adampaigge/openplane/files/dxf/parts/F-TT1.dxf

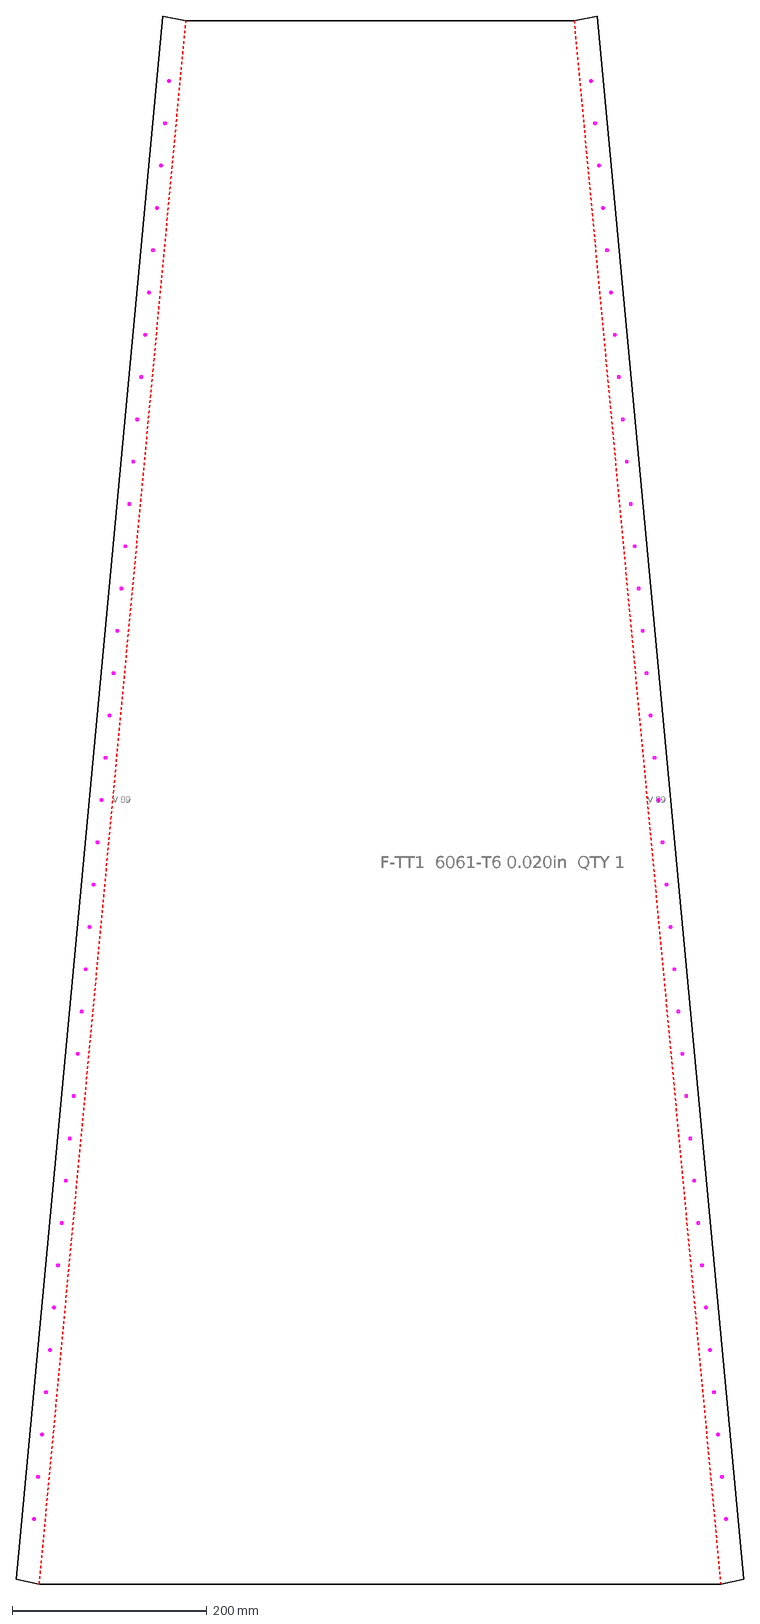
[picture p1: CAD file, 2026-10-21]
files/dxf/parts/F-TT1.dxf
V 89
F-TT1 6061-T6 0.020in QTY 1
