adampaigge/openplane/files/prop/OpenPlane_prop_54x24.stl

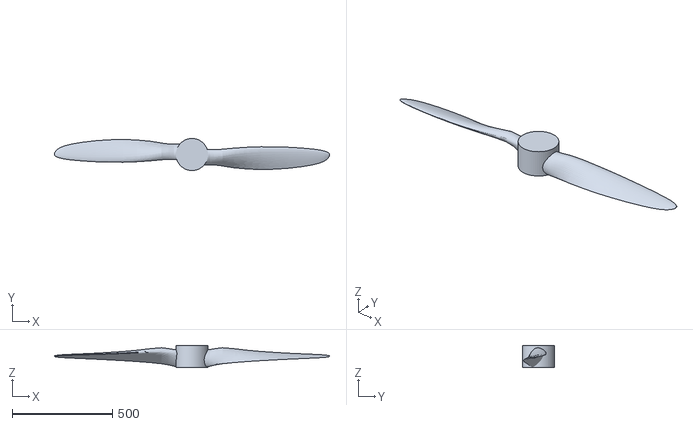
[picture p2: CAD file, 2026-10-21]
files/prop/OpenPlane_prop_54x24.stl
1371.6 x 160.0 x 110.6
