adampaigge/openplane/files/dxf/nests/4130_steel_0063in_01.dxf

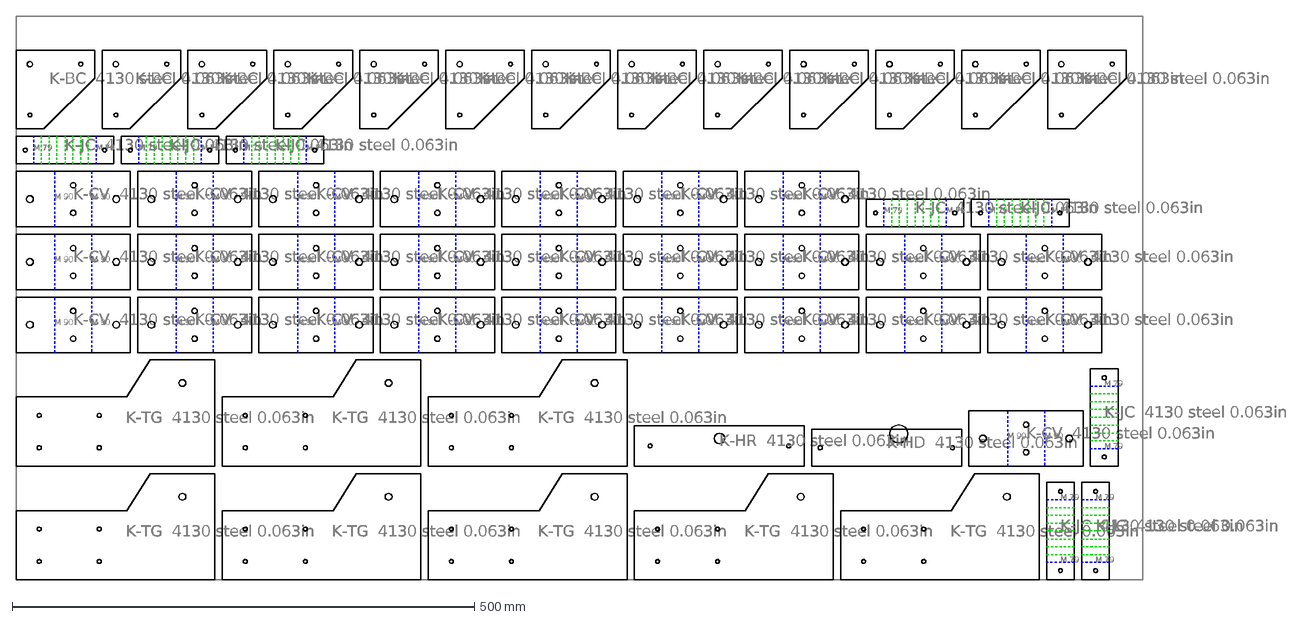
[picture p3: CAD file, 2026-10-21]
files/dxf/nests/4130_steel_0063in_01.dxf
K-TG 4130 steel 0.063in
K-HR 4130 steel 0.063in
K-HD 4130 steel 0.063in
M 90
K-CV 4130 steel 0.063in
M 79
K-JC 4130 steel 0.063in
K-BC 4130 steel 0.063in
