adampaigge/openplane/files/dxf/parts/K-HN.dxf

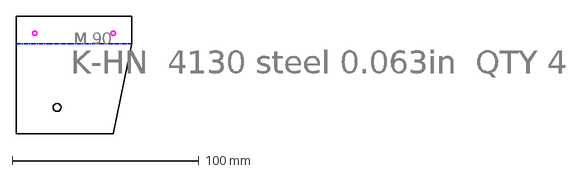
[picture p4: CAD file, 2026-10-21]
files/dxf/parts/K-HN.dxf
M 90
K-HN 4130 steel 0.063in QTY 4
