adampaigge/openplane/files/dxf/parts/T-FR.dxf

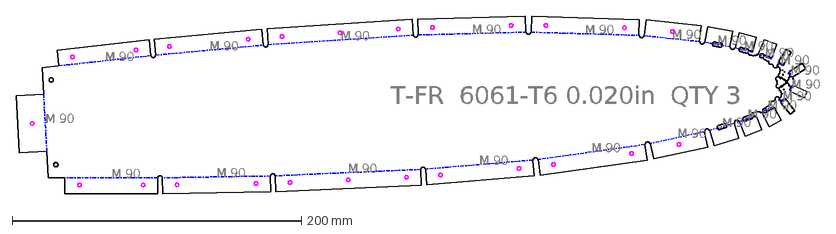
[picture p5: CAD file, 2026-10-21]
files/dxf/parts/T-FR.dxf
M 90
T-FR 6061-T6 0.020in QTY 3
