adampaigge/openplane/files/dxf/parts/T-HR.dxf

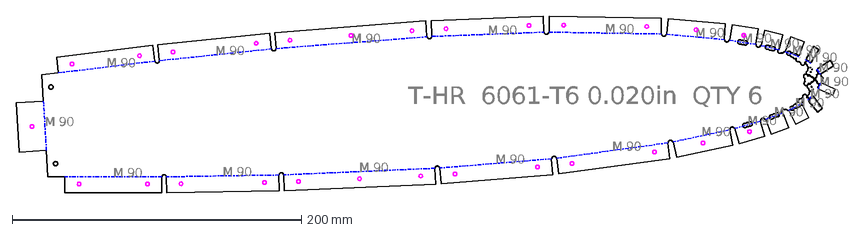
[picture p6: CAD file, 2026-10-21]
files/dxf/parts/T-HR.dxf
M 90
T-HR 6061-T6 0.020in QTY 6
