adampaigge/openplane/files/dxf/nests/6061-T6_0020in_19.dxf

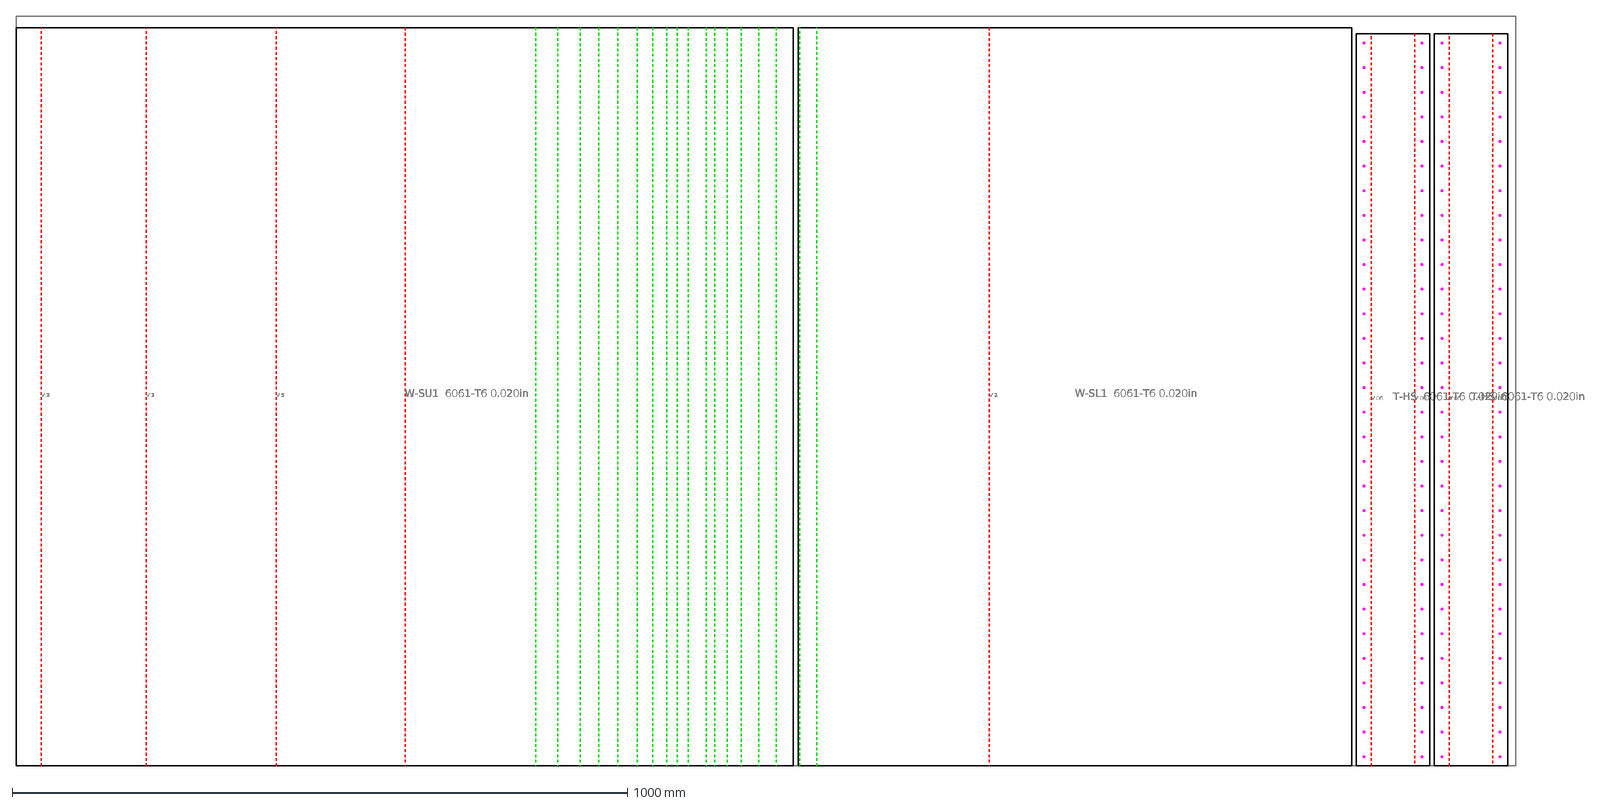
[picture p7: CAD file, 2026-10-21]
files/dxf/nests/6061-T6_0020in_19.dxf
V 9
V 5
V 3
W-SU1 6061-T6 0.020in
V 2
W-SL1 6061-T6 0.020in
V 86
T-HS 6061-T6 0.020in
