adampaigge/openplane/files/dxf/parts/T-FS.dxf

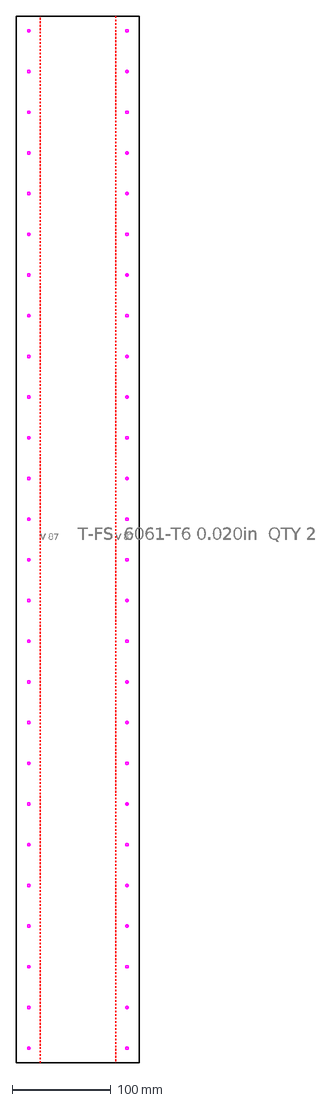
[picture p8: CAD file, 2026-10-21]
files/dxf/parts/T-FS.dxf
V 87
T-FS 6061-T6 0.020in QTY 2
