adampaigge/openplane/files/dxf/parts/K-HR.dxf

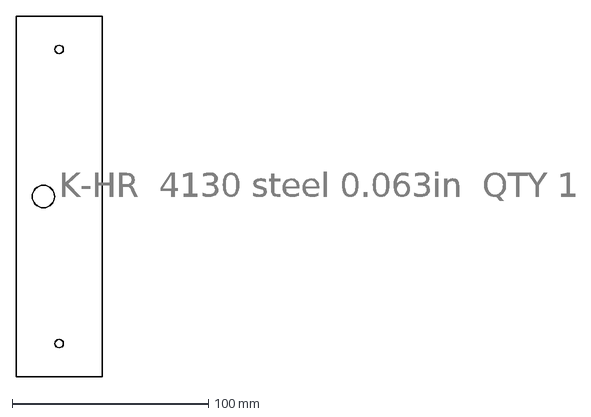
[picture p9: CAD file, 2026-10-21]
files/dxf/parts/K-HR.dxf
K-HR 4130 steel 0.063in QTY 1
