adampaigge/openplane/files/dxf/parts/W-MRe.dxf

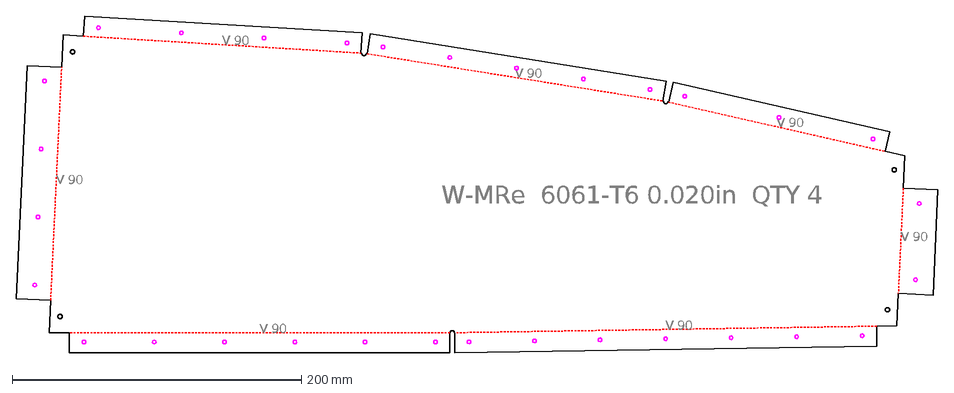
[picture p10: CAD file, 2026-10-21]
files/dxf/parts/W-MRe.dxf
V 90
W-MRe 6061-T6 0.020in QTY 4
