adampaigge/openplane/files/dxf/parts/F-NU.dxf

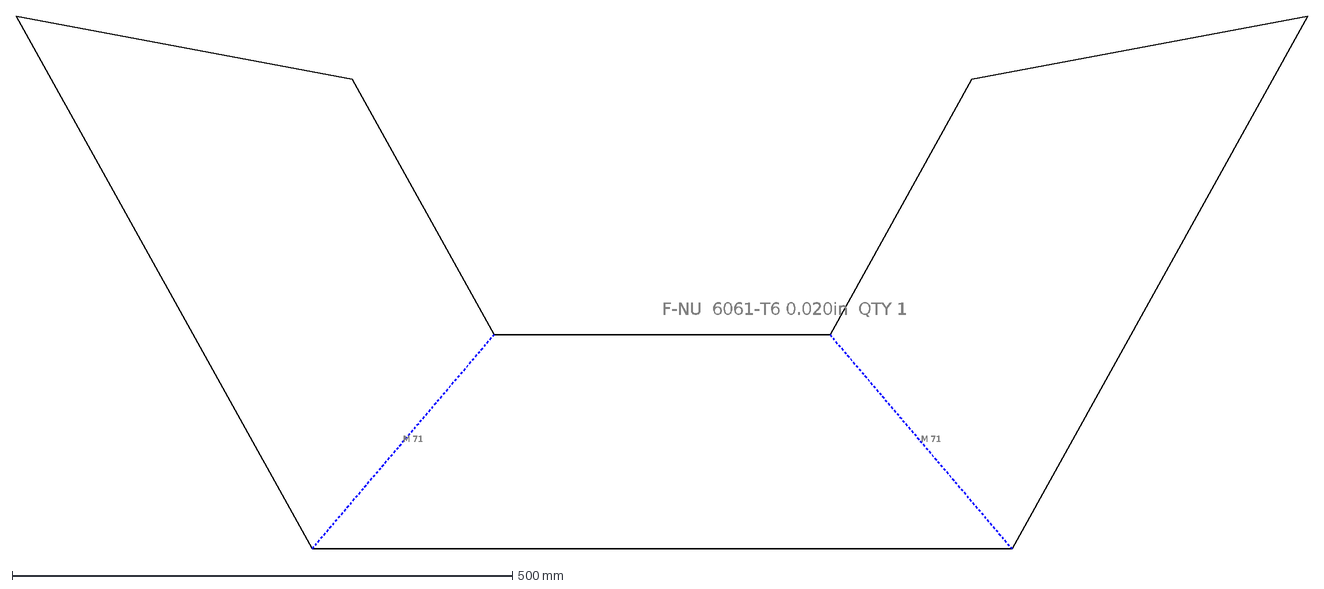
[picture p11: CAD file, 2026-10-21]
files/dxf/parts/F-NU.dxf
M 71
F-NU 6061-T6 0.020in QTY 1
