adampaigge/openplane/files/dxf/parts/W-SU1.dxf

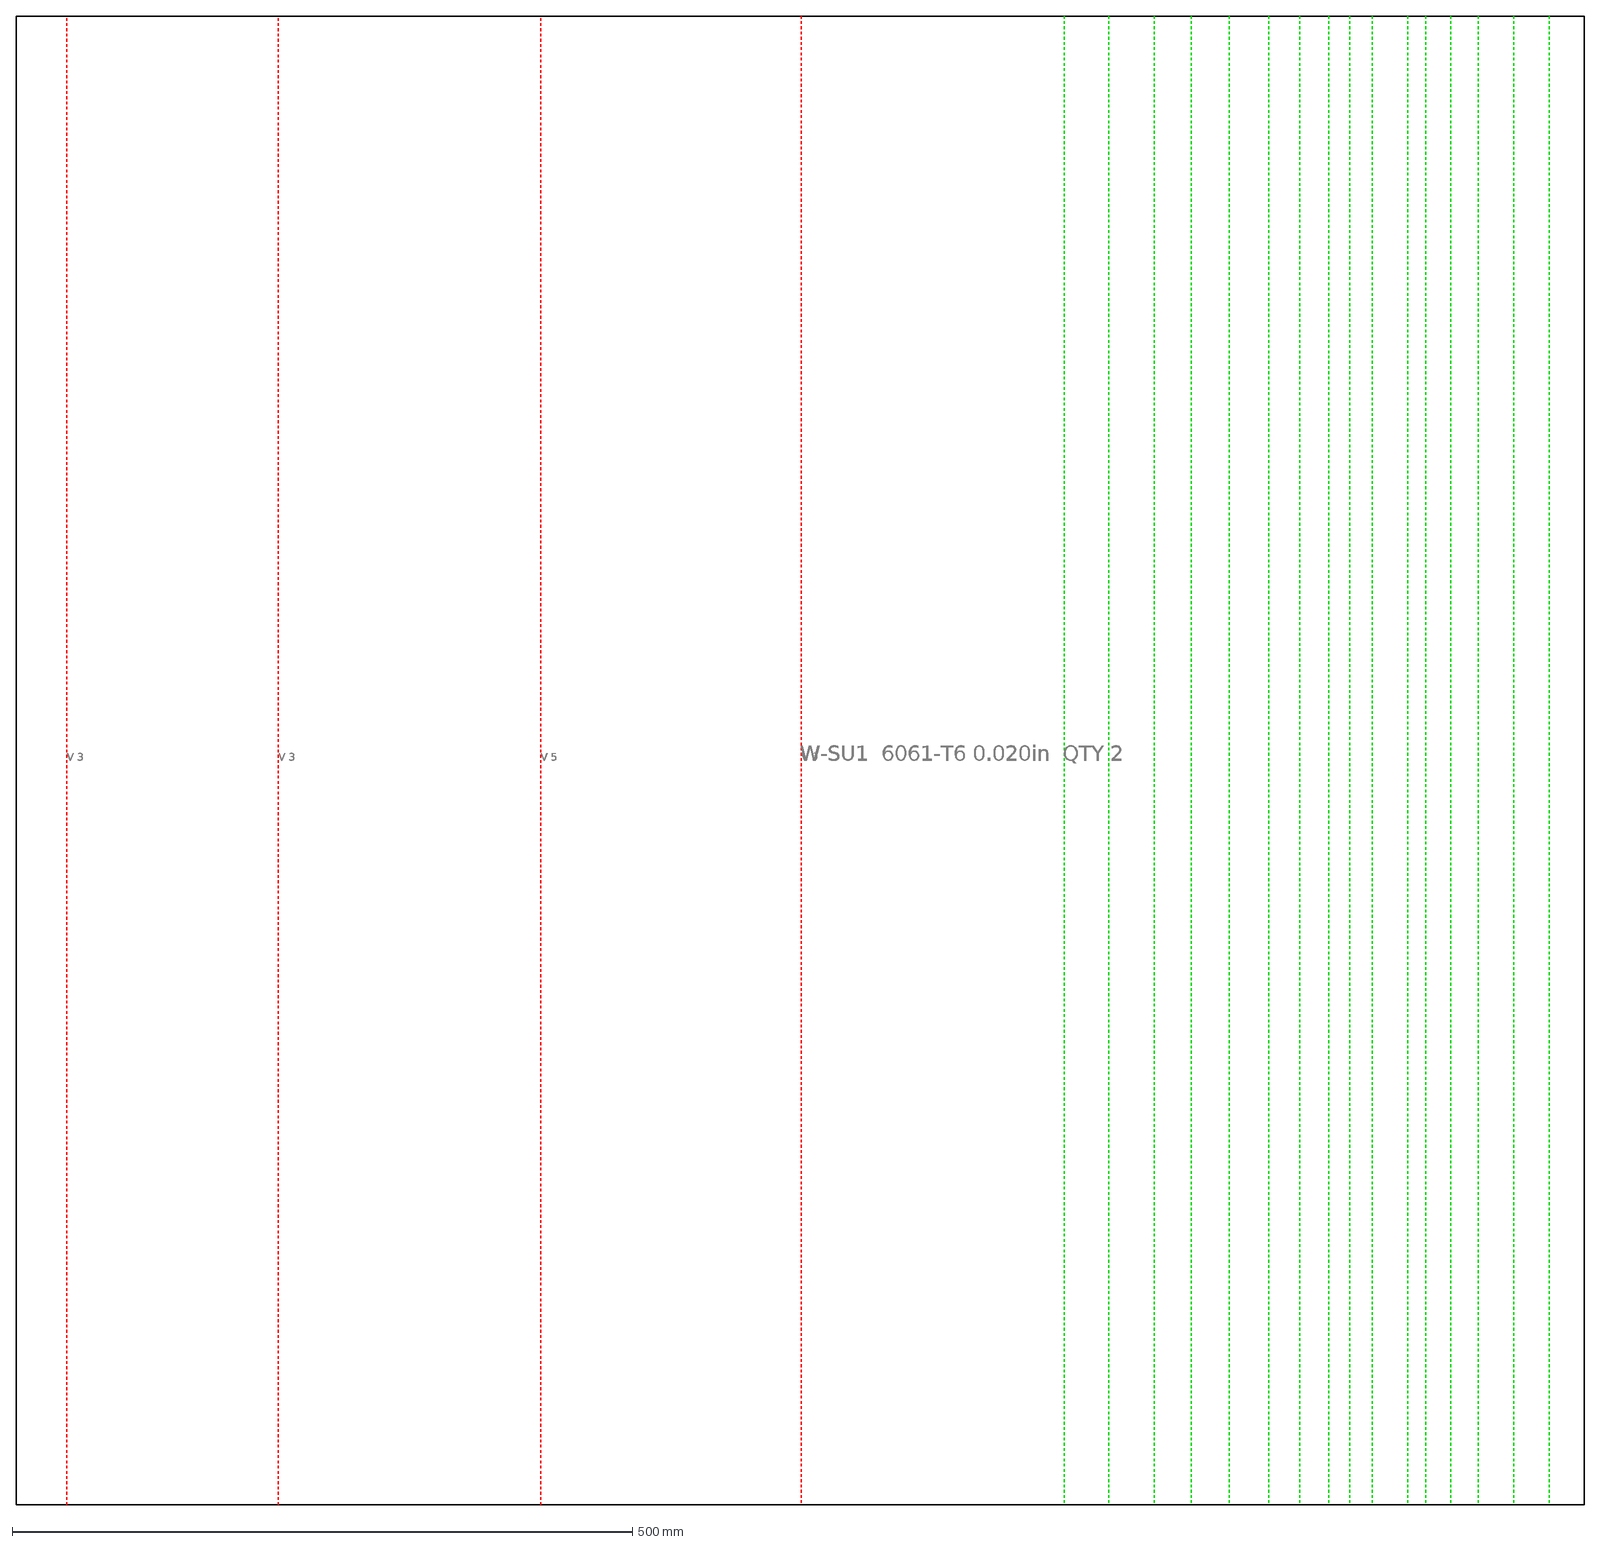
[picture p12: CAD file, 2026-10-21]
files/dxf/parts/W-SU1.dxf
V 9
V 5
V 3
W-SU1 6061-T6 0.020in QTY 2
