adampaigge/openplane/files/dxf/parts/F-B1.dxf

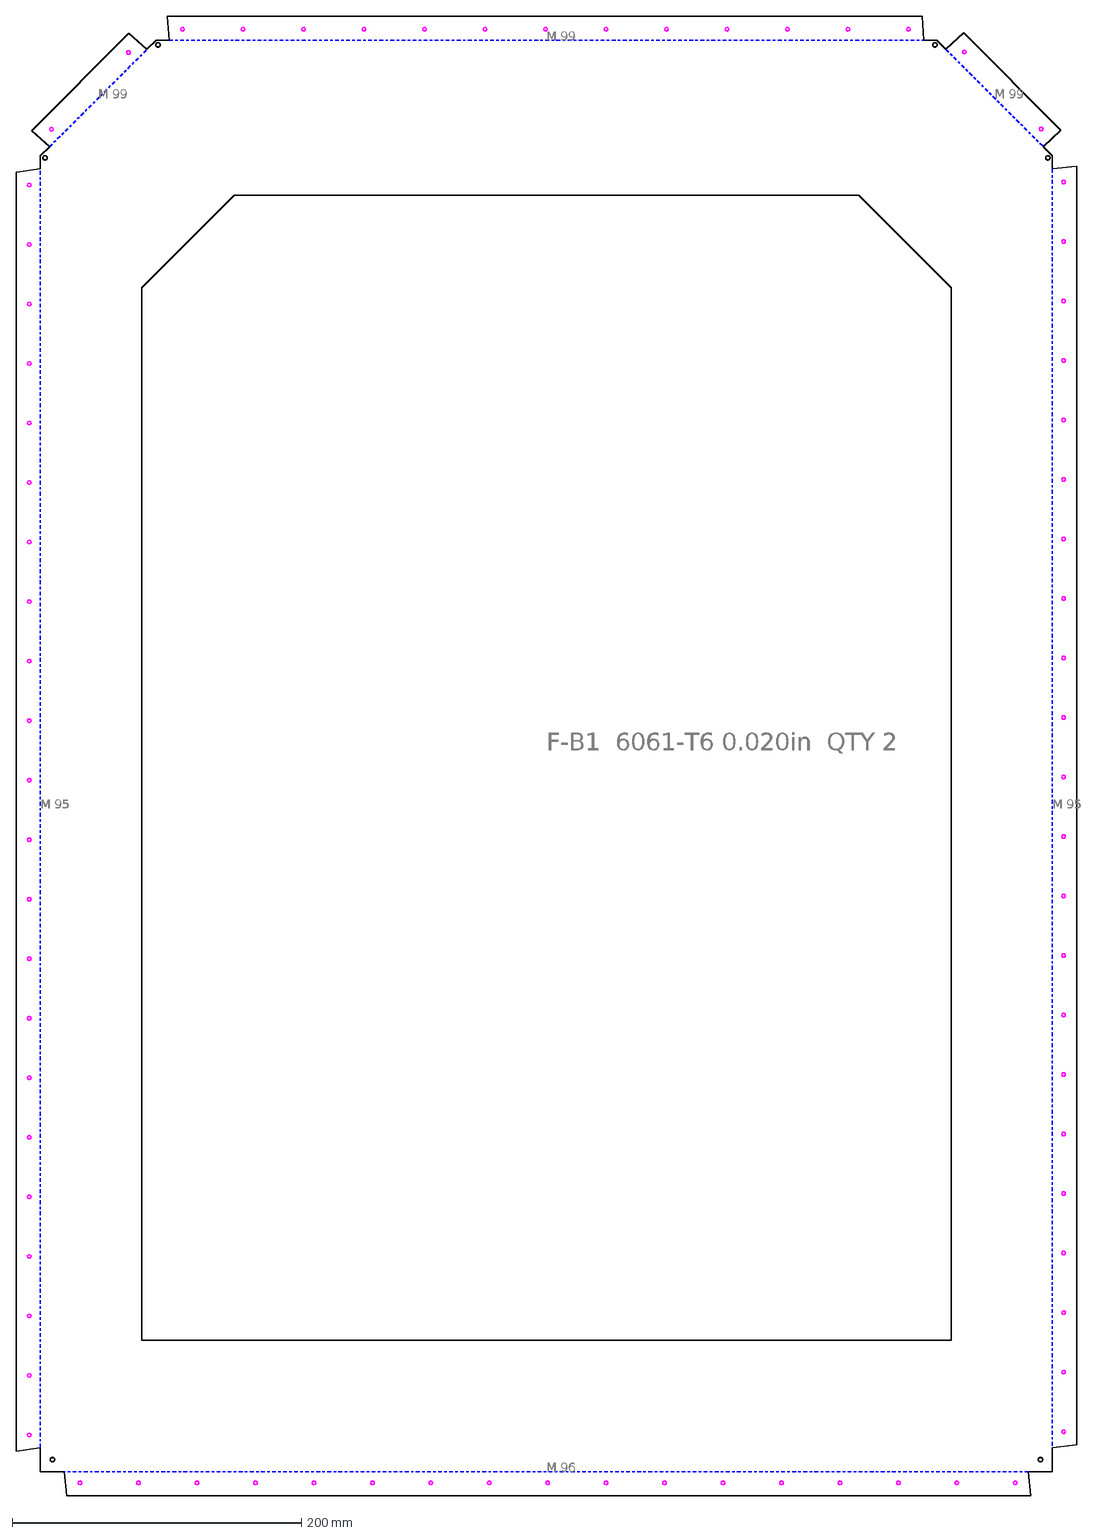
[picture p13: CAD file, 2026-10-21]
files/dxf/parts/F-B1.dxf
M 96
M 95
M 99
F-B1 6061-T6 0.020in QTY 2
