adampaigge/openplane/files/dxf/parts/F-CL.dxf

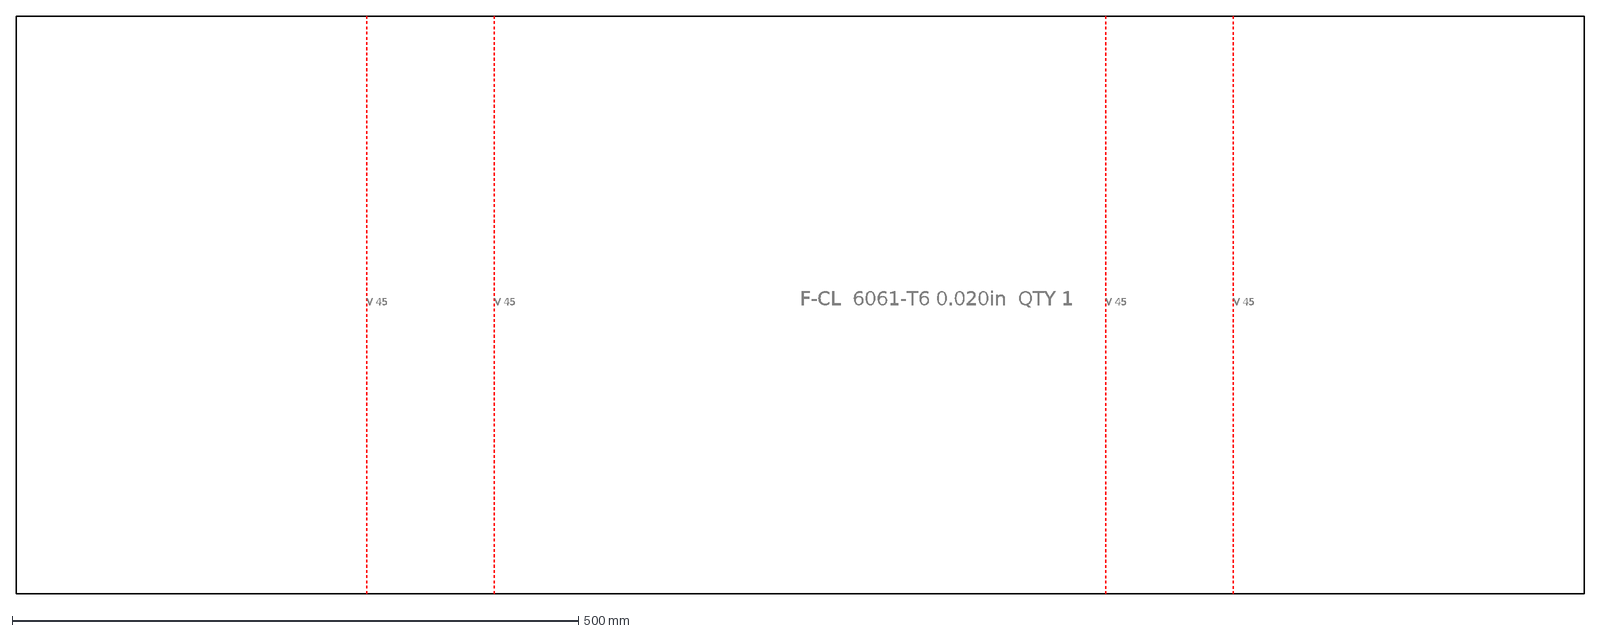
[picture p14: CAD file, 2026-10-21]
files/dxf/parts/F-CL.dxf
V 45
F-CL 6061-T6 0.020in QTY 1
