adampaigge/openplane/files/dxf/parts/F-CU.dxf

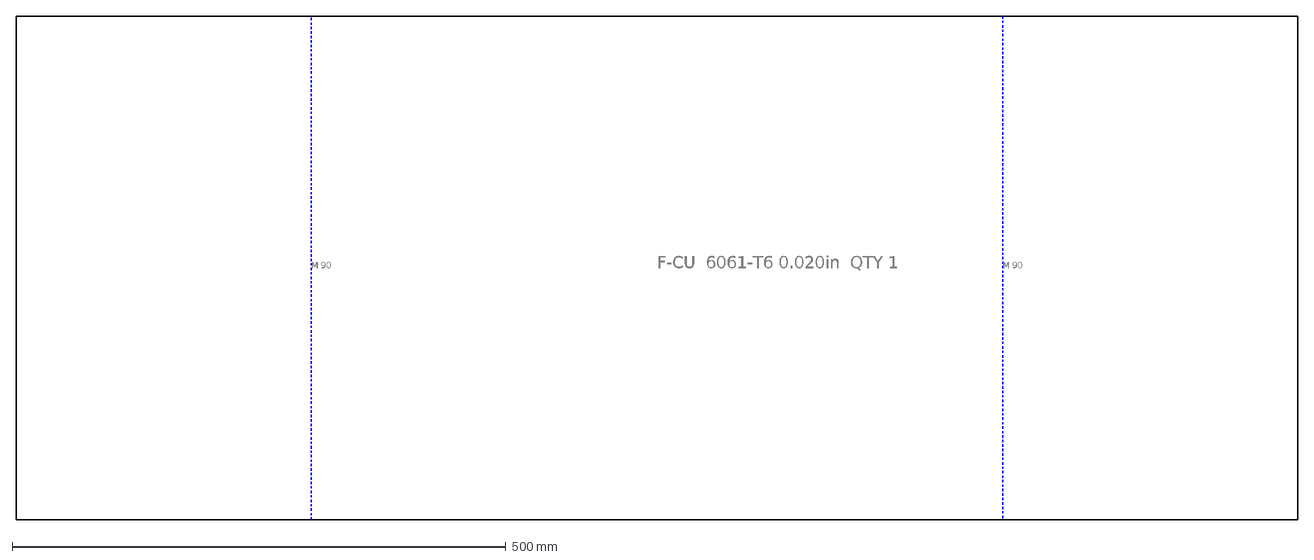
[picture p15: CAD file, 2026-10-21]
files/dxf/parts/F-CU.dxf
M 90
F-CU 6061-T6 0.020in QTY 1
