adampaigge/openplane/files/dxf/parts/F-SD.dxf

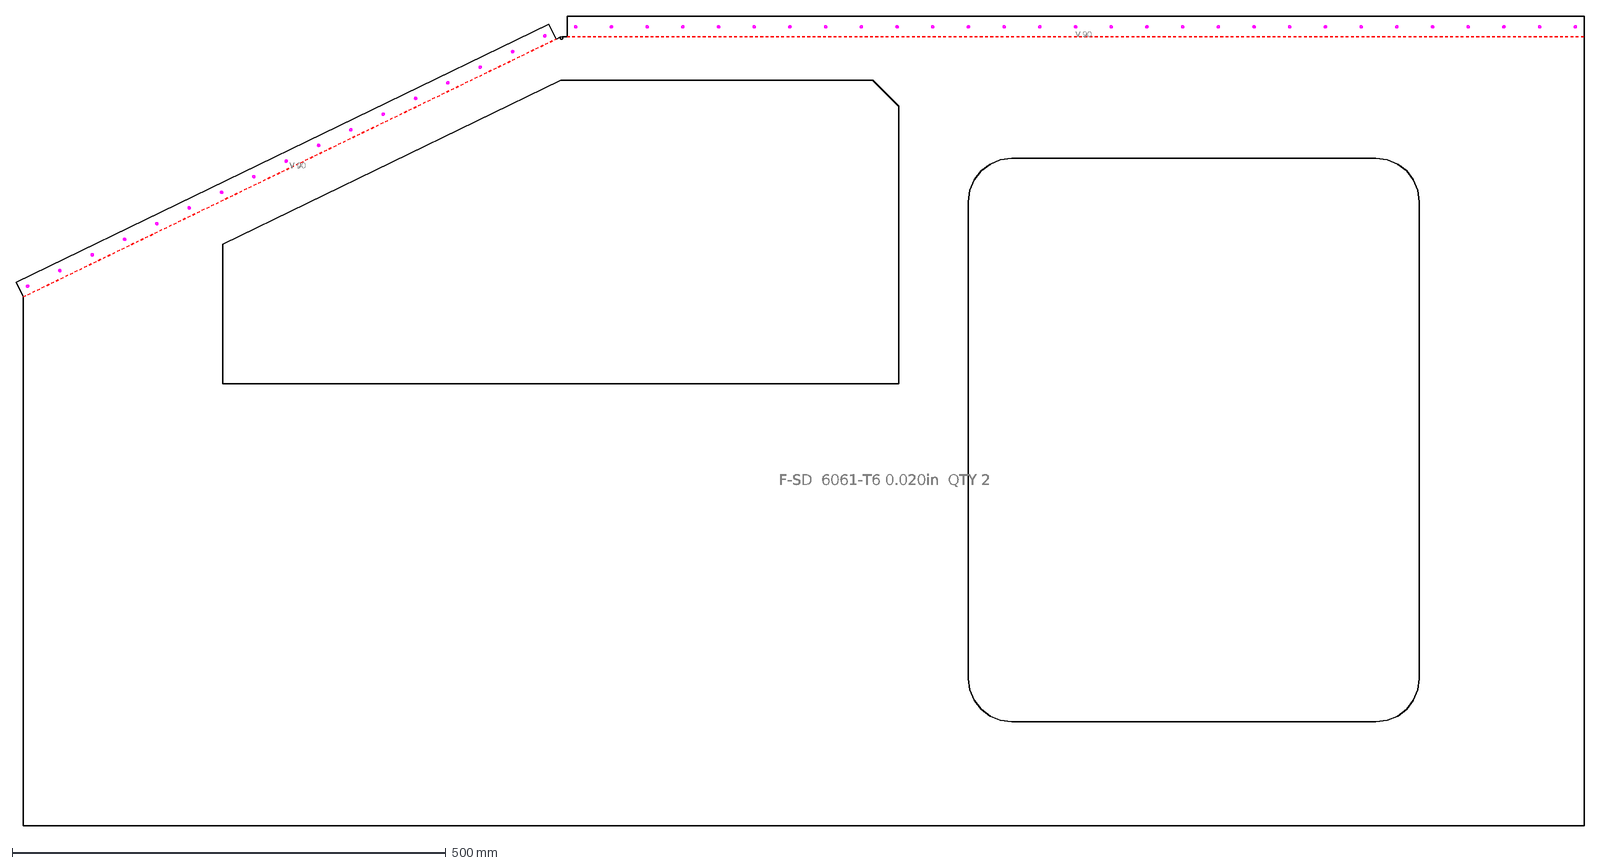
[picture p16: CAD file, 2026-10-21]
files/dxf/parts/F-SD.dxf
V 90
F-SD 6061-T6 0.020in QTY 2
