adampaigge/openplane/files/dxf/parts/F-NF.dxf

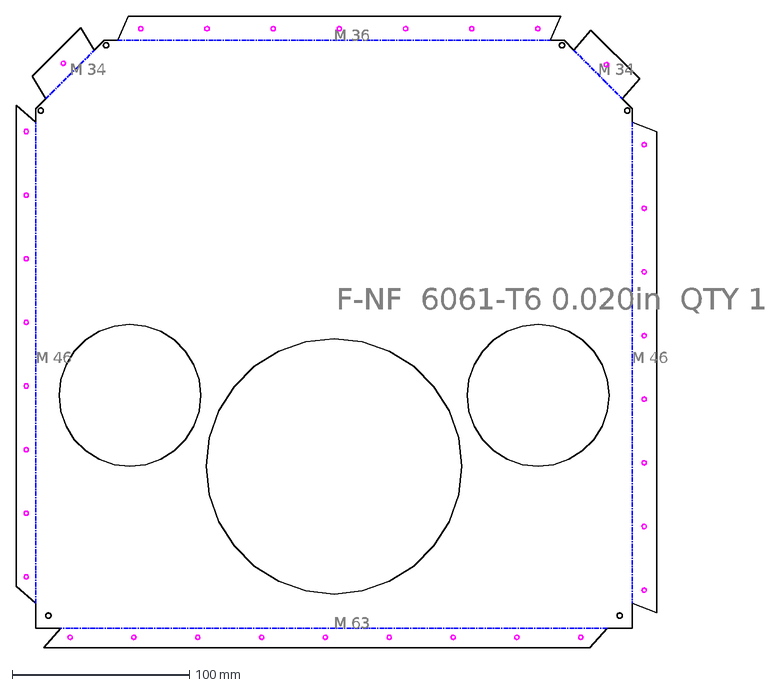
[picture p17: CAD file, 2026-10-21]
files/dxf/parts/F-NF.dxf
M 63
M 46
M 34
M 36
F-NF 6061-T6 0.020in QTY 1
