adampaigge/openplane/files/dxf/parts/T-RS.dxf

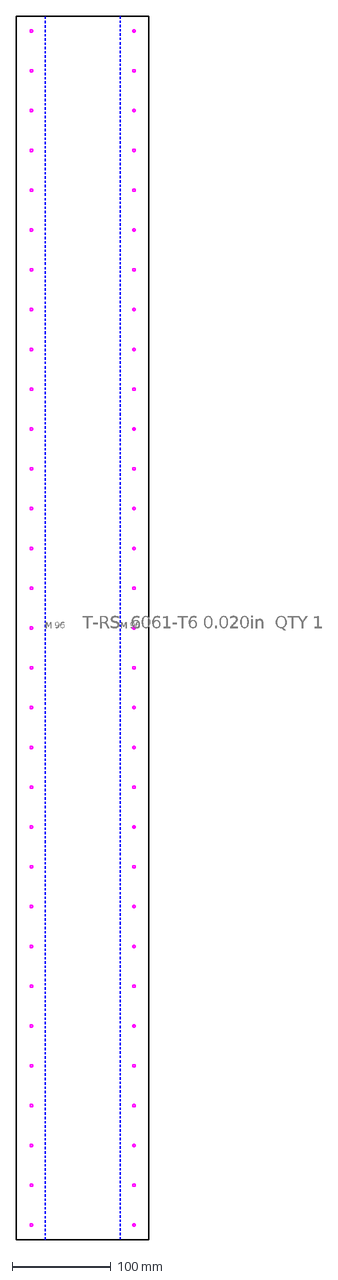
[picture p18: CAD file, 2026-10-21]
files/dxf/parts/T-RS.dxf
M 96
T-RS 6061-T6 0.020in QTY 1
