adampaigge/openplane/files/dxf/parts/T-FK.dxf

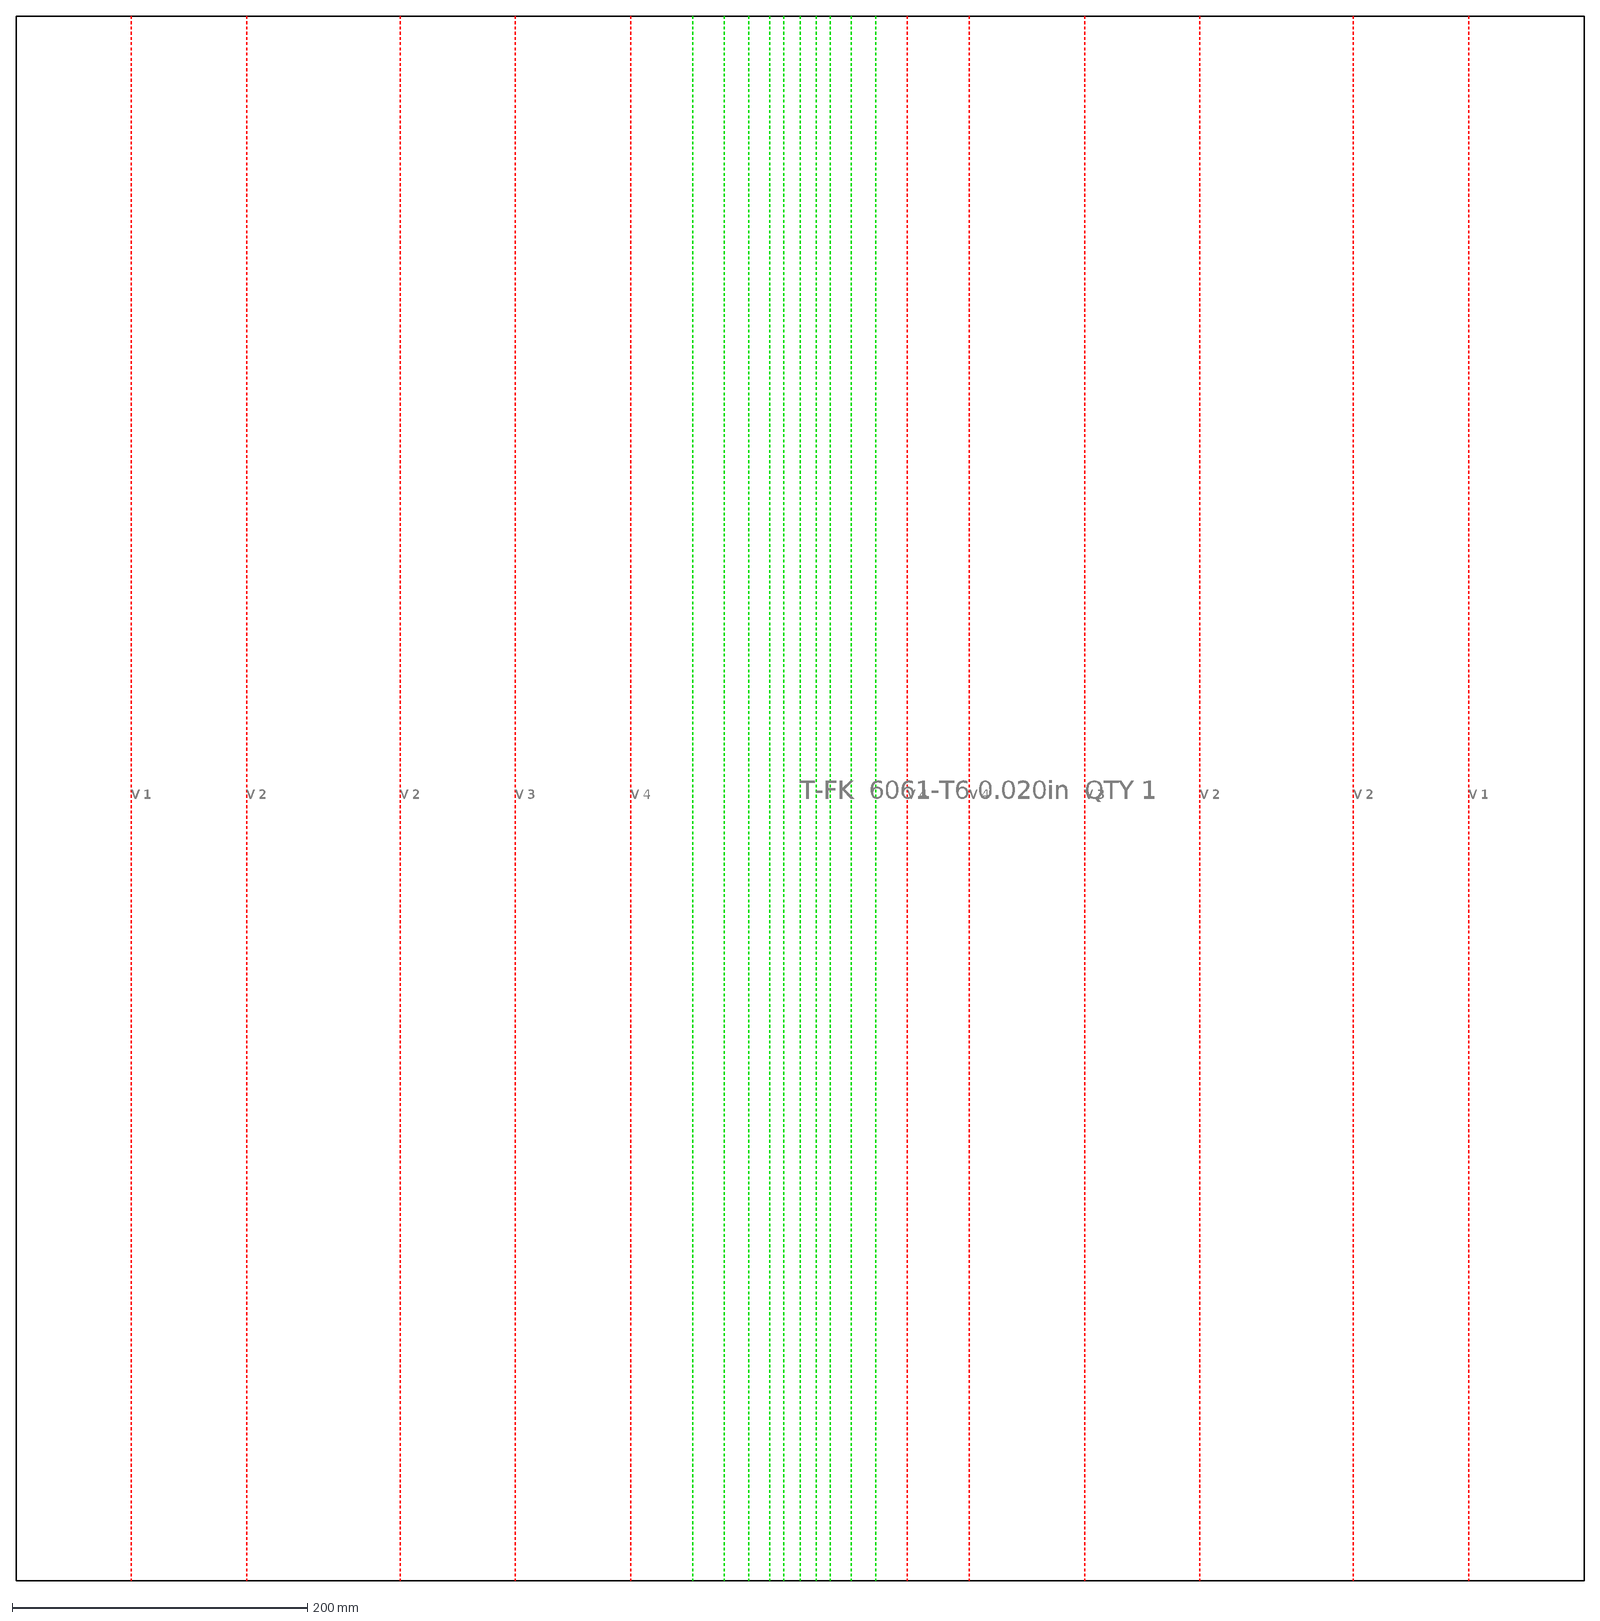
[picture p19: CAD file, 2026-10-21]
files/dxf/parts/T-FK.dxf
V 1
V 2
V 3
V 4
T-FK 6061-T6 0.020in QTY 1
