adampaigge/openplane/files/dxf/nests/6061-T6_0020in_15.dxf

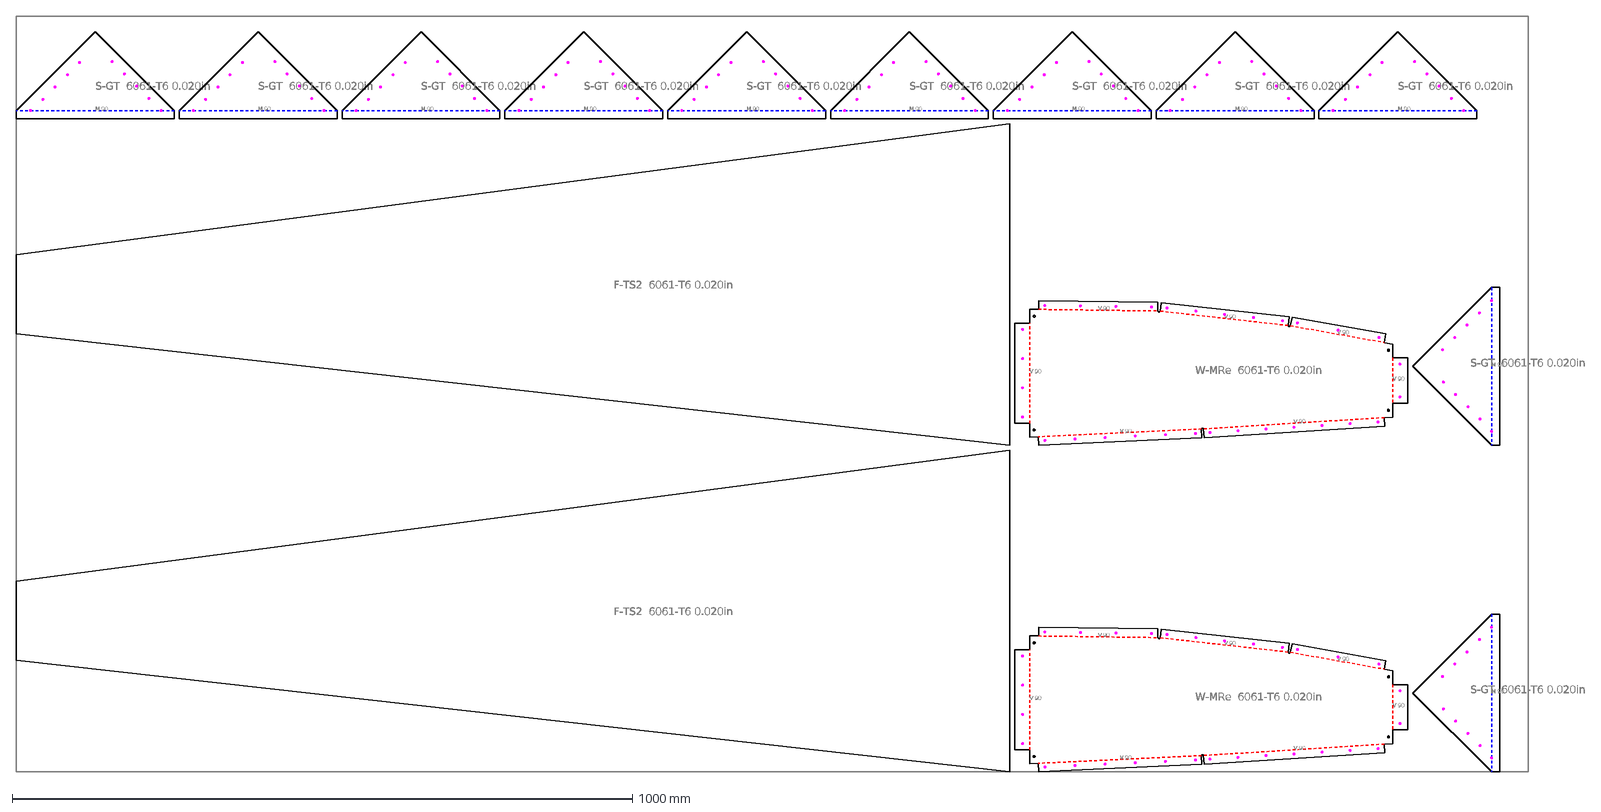
[picture p20: CAD file, 2026-10-21]
files/dxf/nests/6061-T6_0020in_15.dxf
F-TS2 6061-T6 0.020in
V 90
W-MRe 6061-T6 0.020in
M 90
S-GT 6061-T6 0.020in
