adampaigge/openplane/files/dxf/parts/W-SL1.dxf

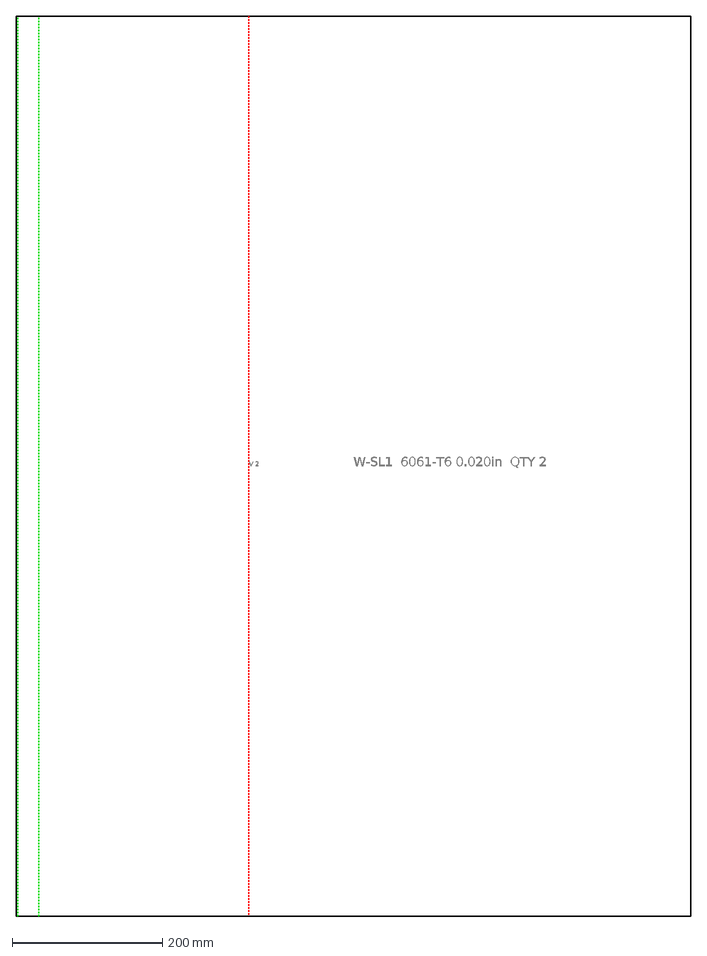
[picture p21: CAD file, 2026-10-21]
files/dxf/parts/W-SL1.dxf
V 2
W-SL1 6061-T6 0.020in QTY 2
