adampaigge/openplane/files/dxf/parts/F-B4.dxf

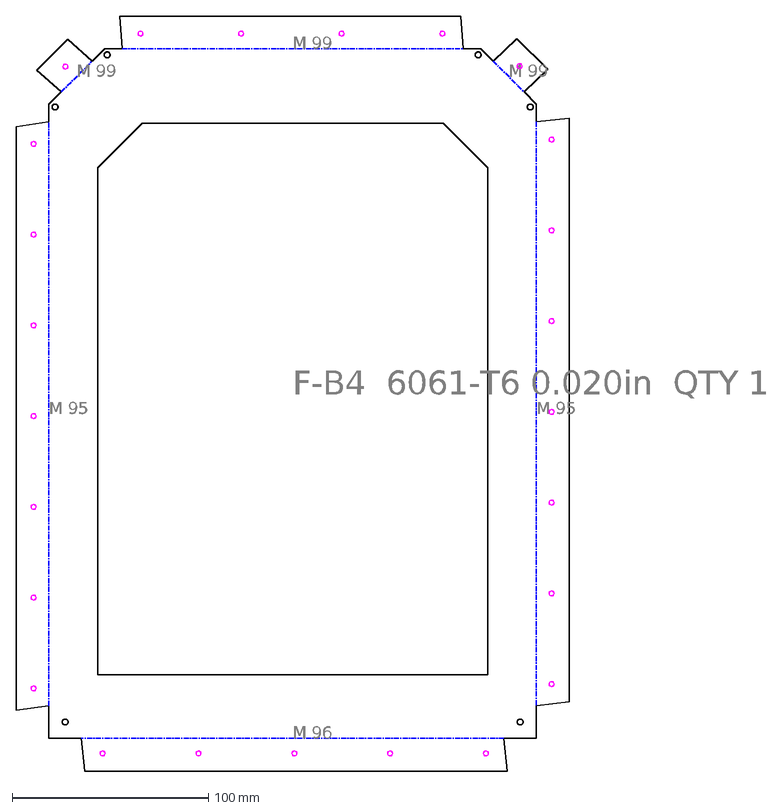
[picture p22: CAD file, 2026-10-21]
files/dxf/parts/F-B4.dxf
M 96
M 95
M 99
F-B4 6061-T6 0.020in QTY 1
