adampaigge/openplane/files/dxf/parts/T-HK.dxf

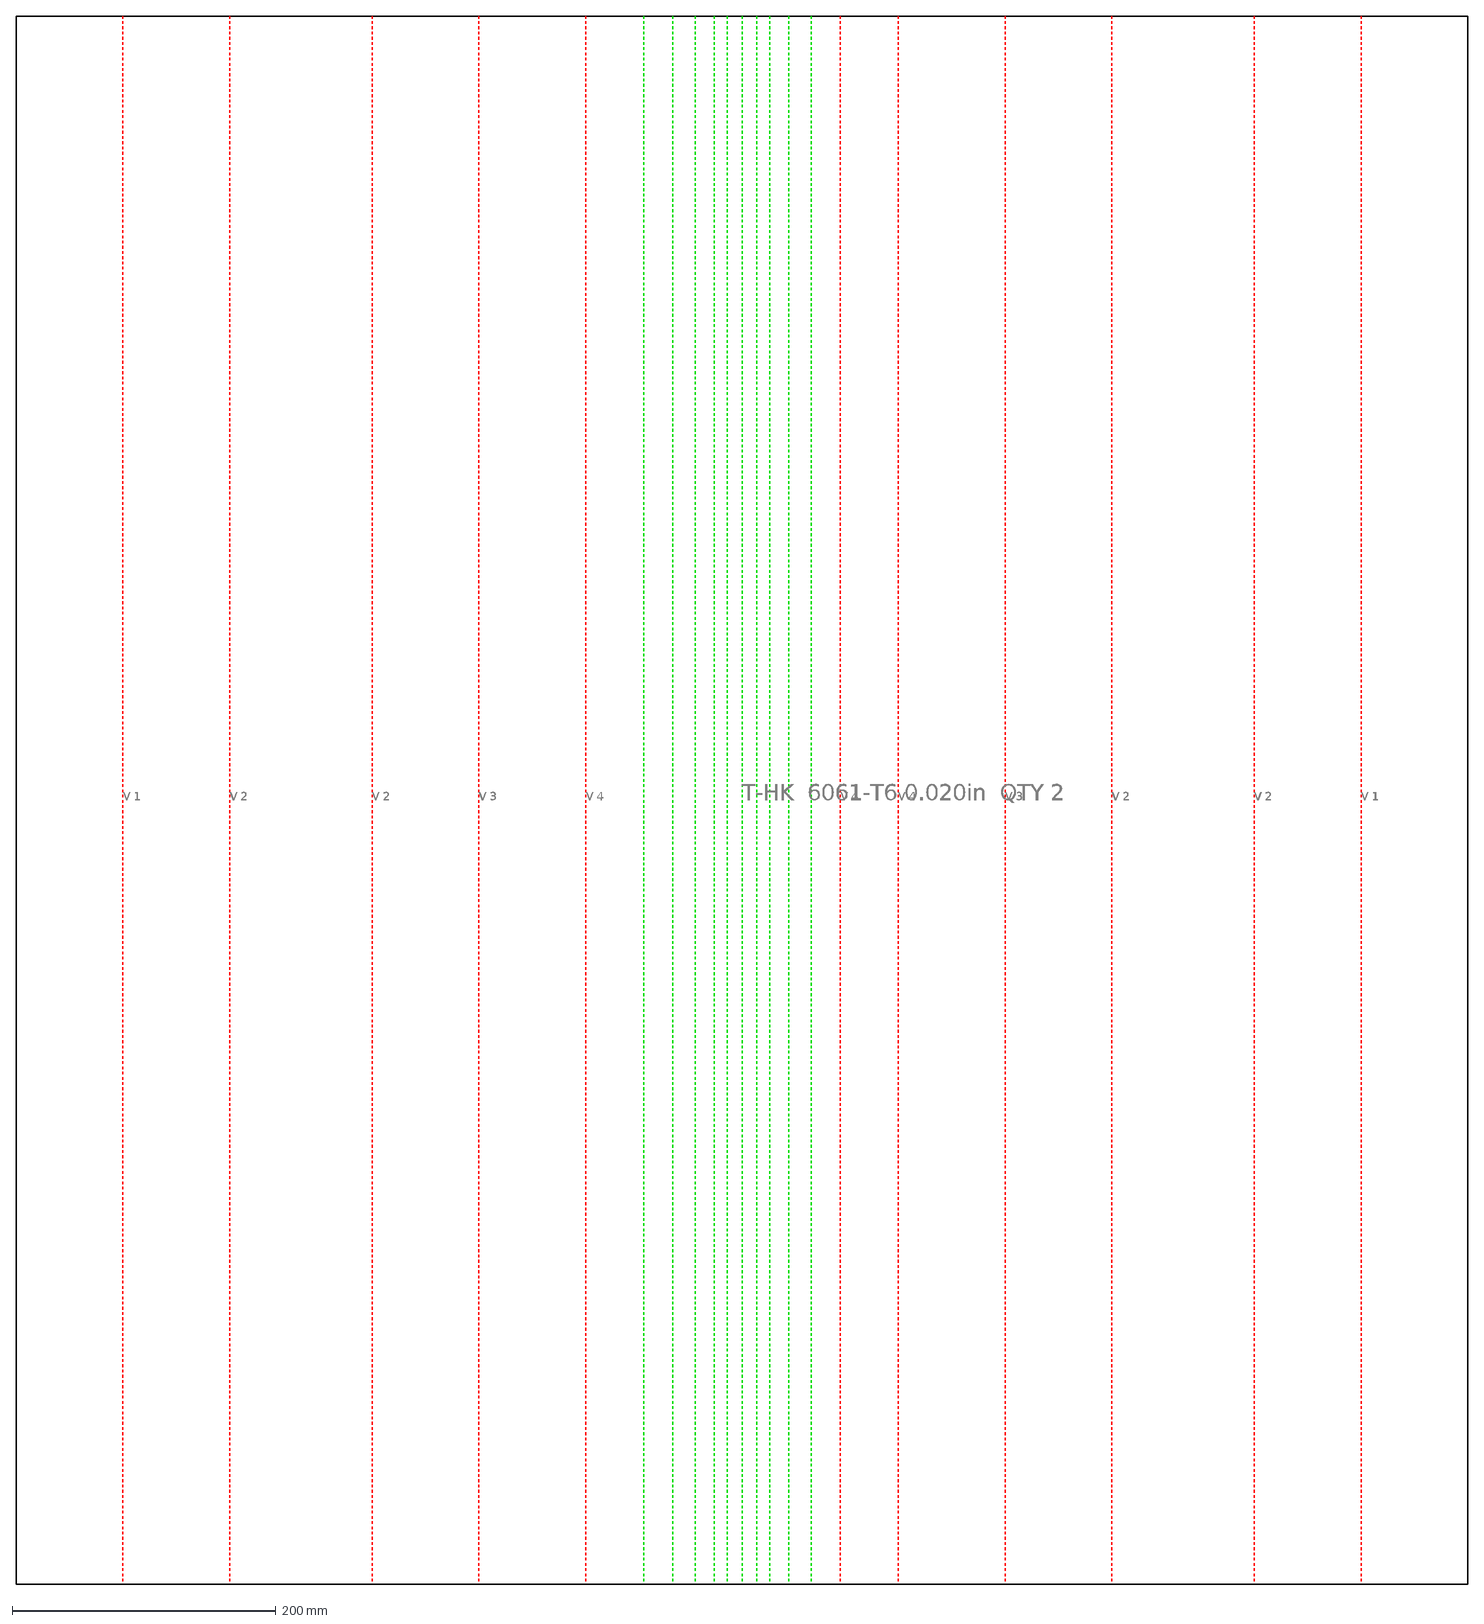
[picture p23: CAD file, 2026-10-21]
files/dxf/parts/T-HK.dxf
V 1
V 2
V 3
V 4
T-HK 6061-T6 0.020in QTY 2
