adampaigge/openplane/files/dxf/parts/S-LG.dxf

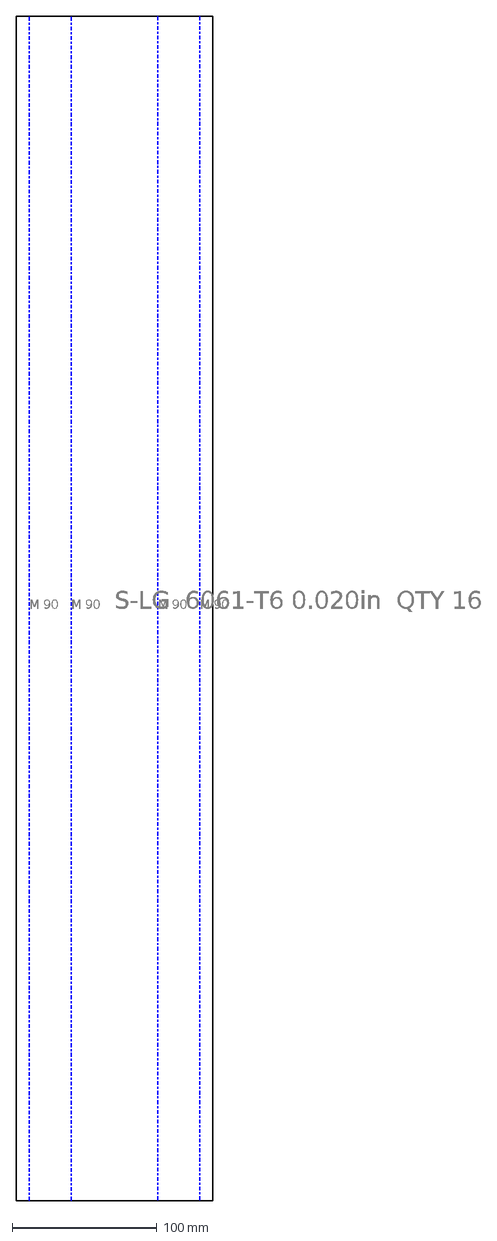
[picture p24: CAD file, 2026-10-21]
files/dxf/parts/S-LG.dxf
M 90
S-LG 6061-T6 0.020in QTY 16
