adampaigge/openplane/files/dxf/parts/F-IP.dxf

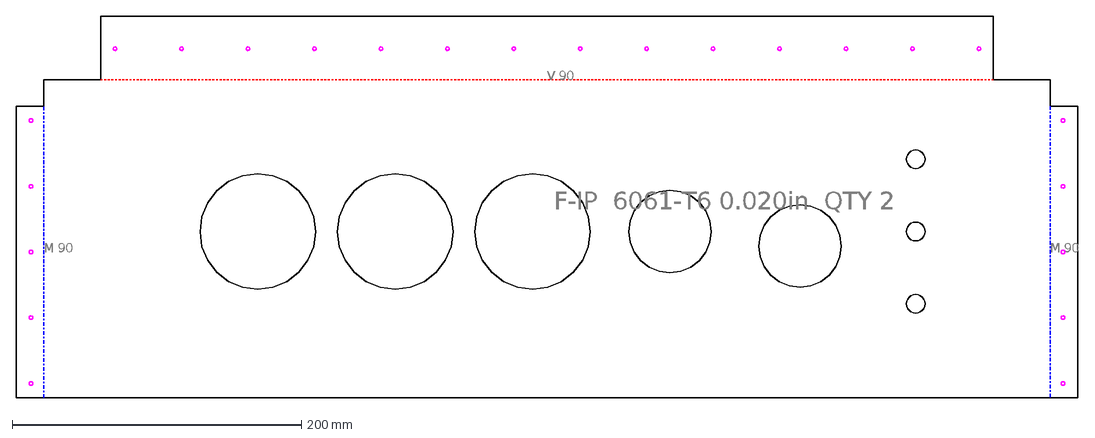
[picture p25: CAD file, 2026-10-21]
files/dxf/parts/F-IP.dxf
V 90
M 90
F-IP 6061-T6 0.020in QTY 2
