adampaigge/openplane/files/dxf/parts/S-FT.dxf

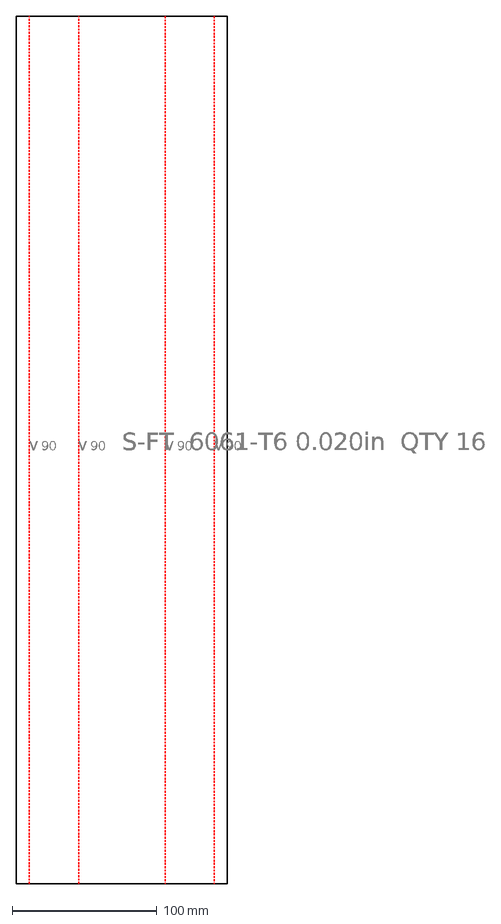
[picture p26: CAD file, 2026-10-21]
files/dxf/parts/S-FT.dxf
V 90
S-FT 6061-T6 0.020in QTY 16
