adampaigge/openplane/files/dxf/nests/4130_steel_0063in_02.dxf

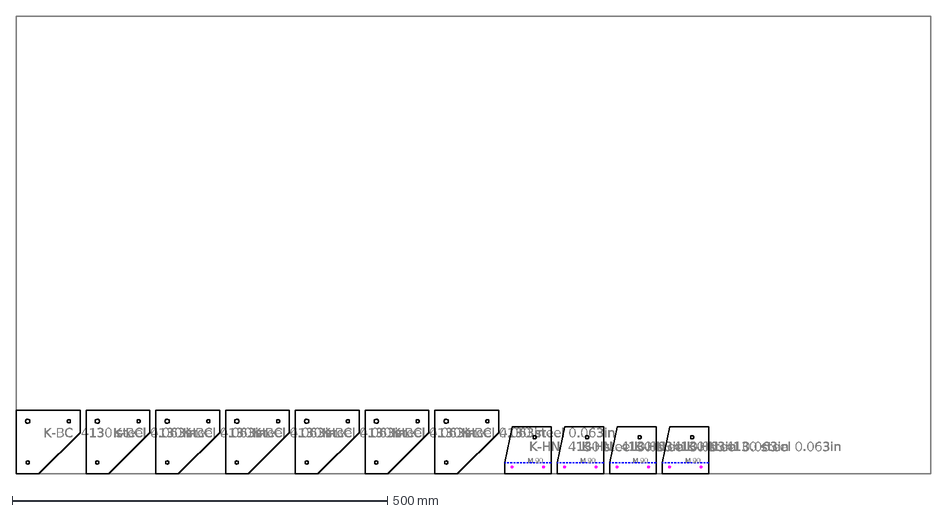
[picture p27: CAD file, 2026-10-21]
files/dxf/nests/4130_steel_0063in_02.dxf
K-BC 4130 steel 0.063in
M 90
K-HN 4130 steel 0.063in
