adampaigge/openplane/files/dxf/parts/T-EK.dxf

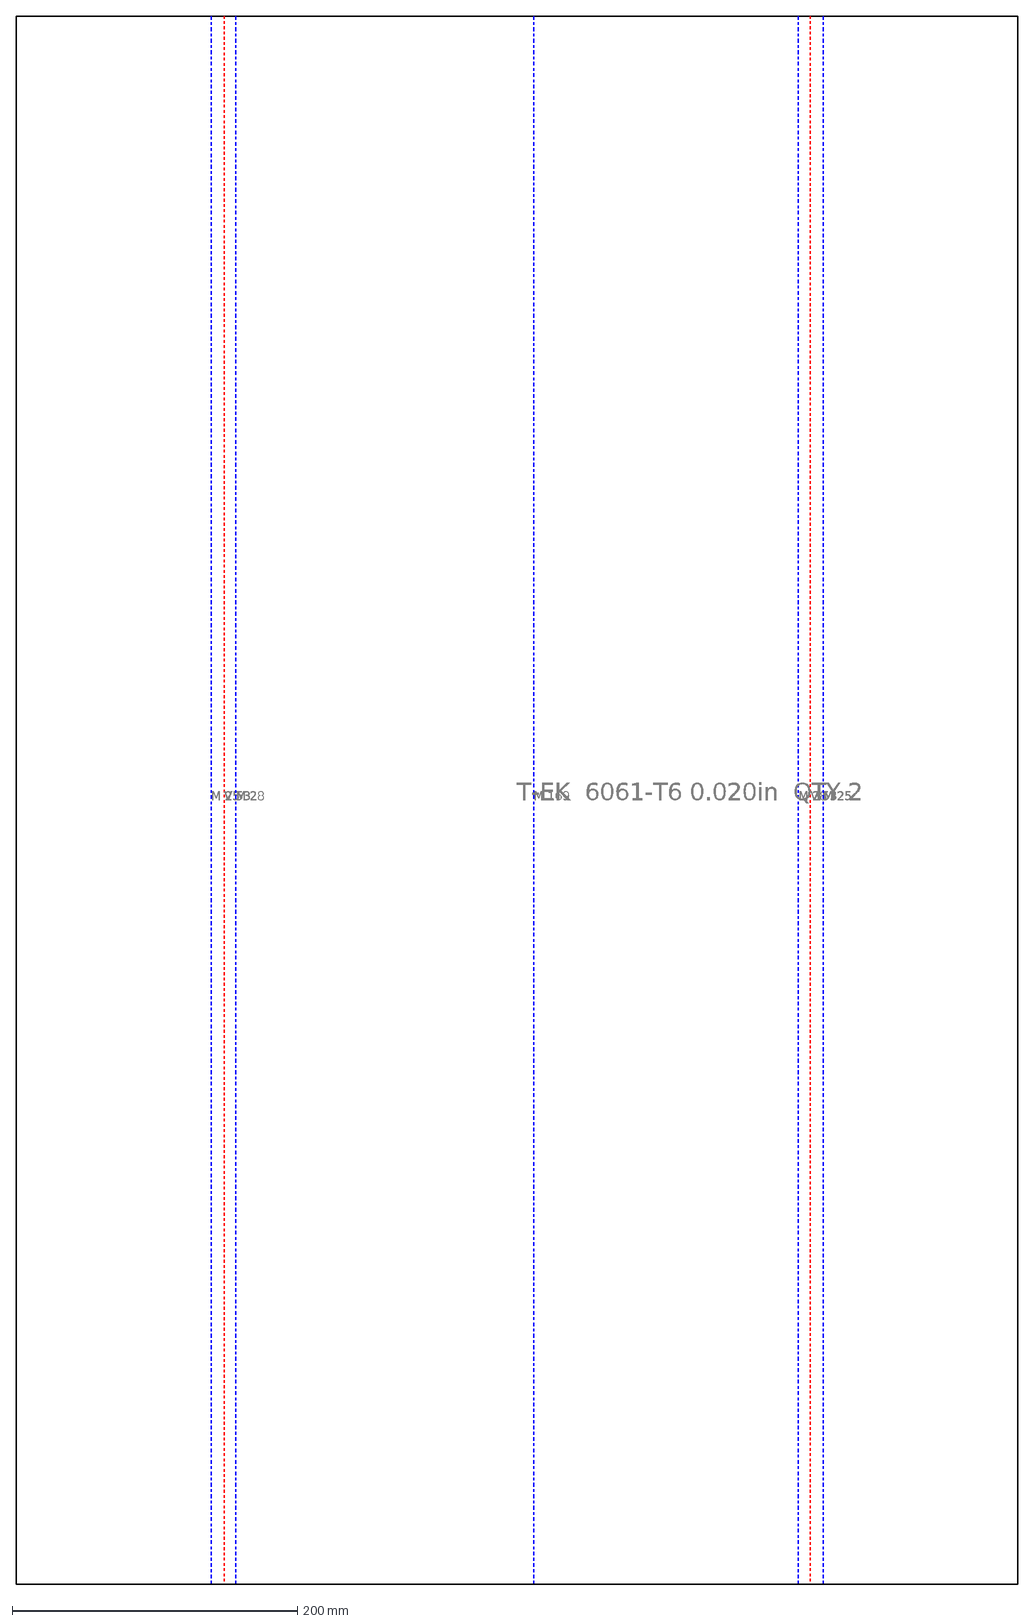
[picture p28: CAD file, 2026-10-21]
files/dxf/parts/T-EK.dxf
M 25
V 53
M 28
M 169
T-EK 6061-T6 0.020in QTY 2
