adampaigge/openplane/files/dxf/parts/F-TS1.dxf

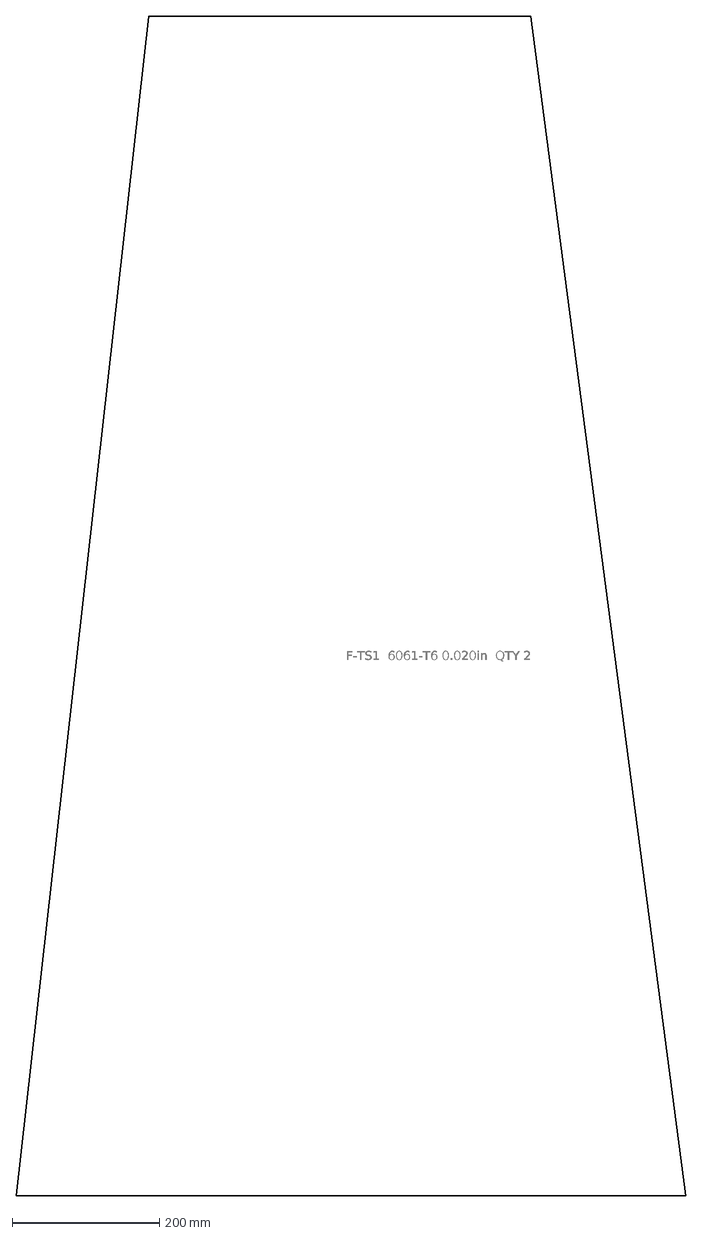
[picture p29: CAD file, 2026-10-21]
files/dxf/parts/F-TS1.dxf
F-TS1 6061-T6 0.020in QTY 2
