adampaigge/openplane/files/dxf/nests/Polycarbonate_2_mm_02.dxf

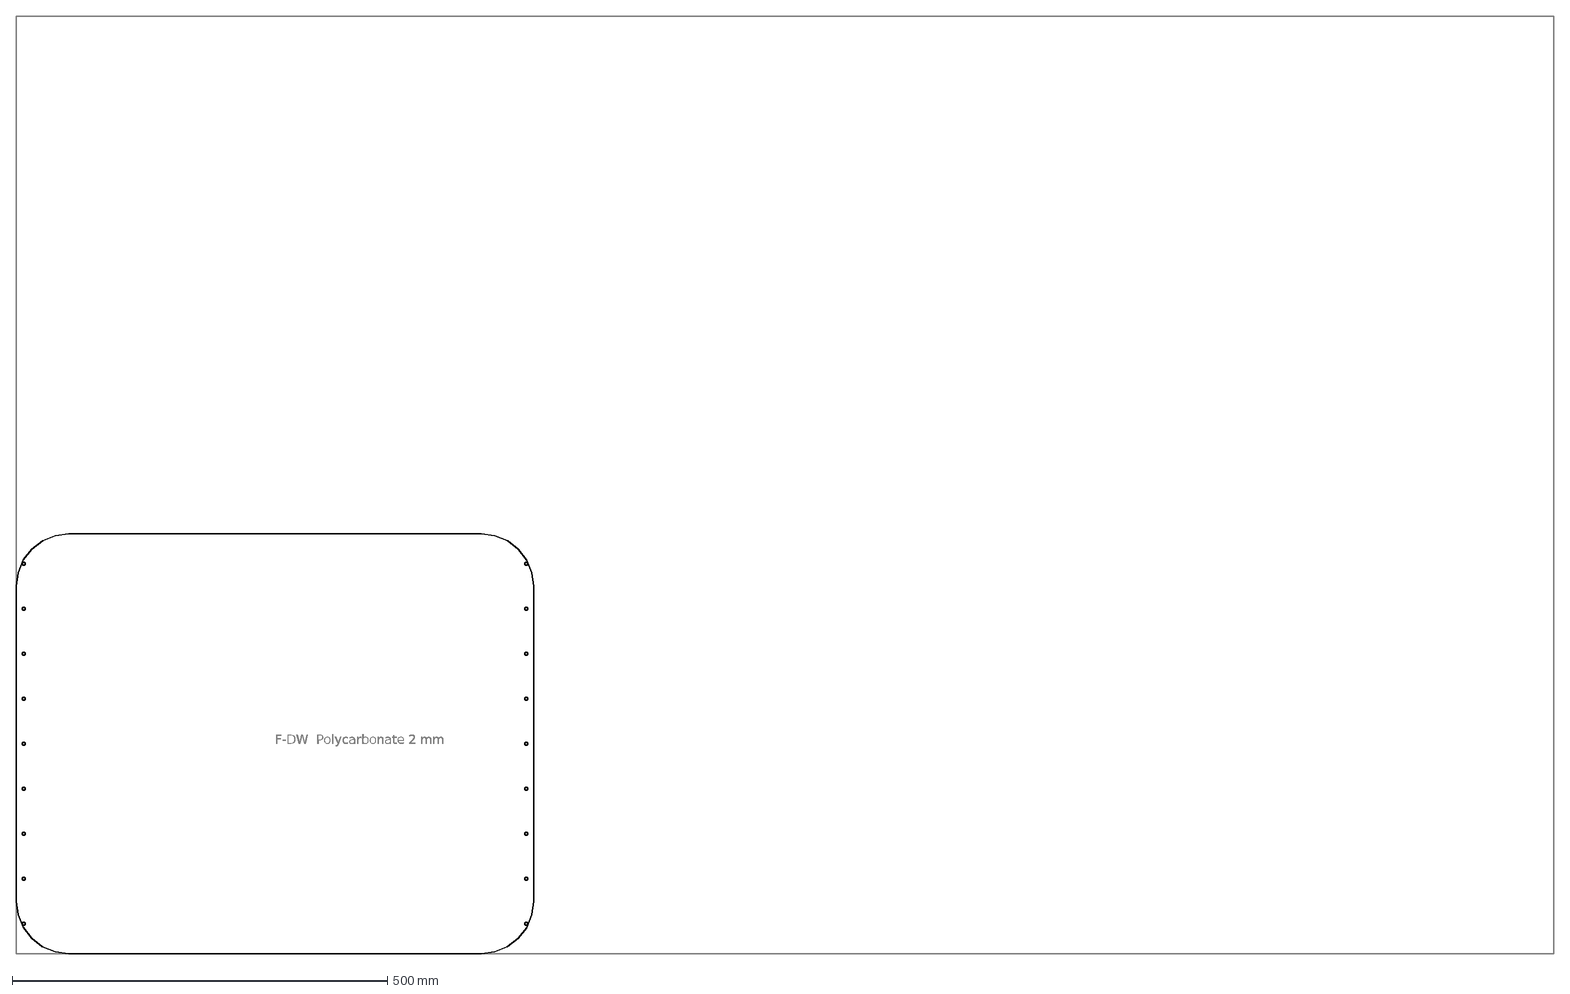
[picture p31: CAD file, 2026-10-21]
files/dxf/nests/Polycarbonate_2_mm_02.dxf
F-DW Polycarbonate 2 mm
