adampaigge/openplane/files/dxf/parts/W-SL2.dxf

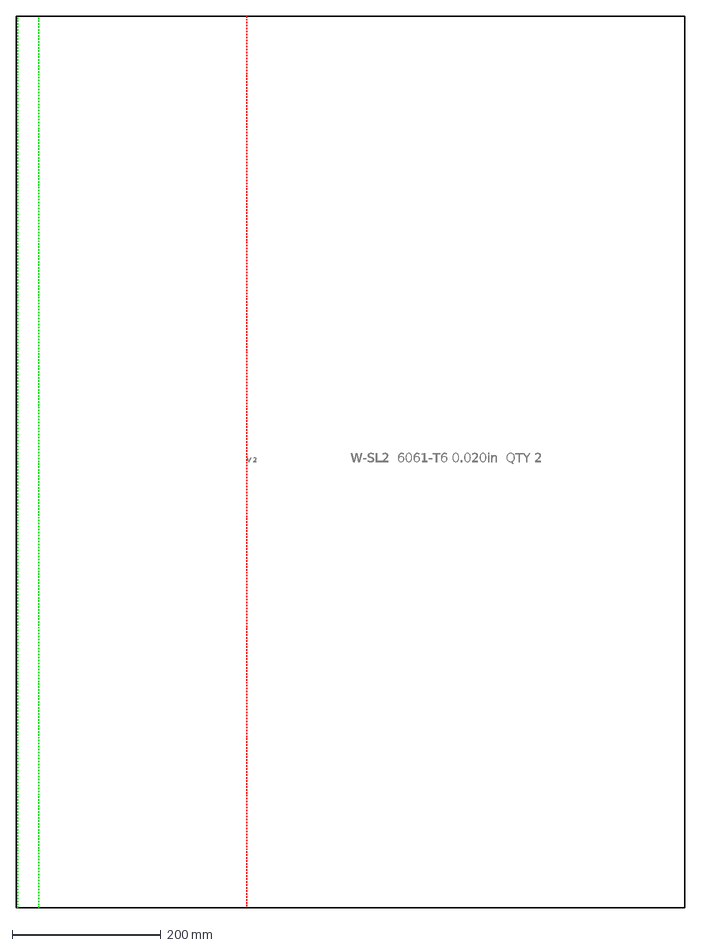
[picture p32: CAD file, 2026-10-21]
files/dxf/parts/W-SL2.dxf
V 2
W-SL2 6061-T6 0.020in QTY 2
