adampaigge/openplane/files/dxf/parts/W-MR.dxf

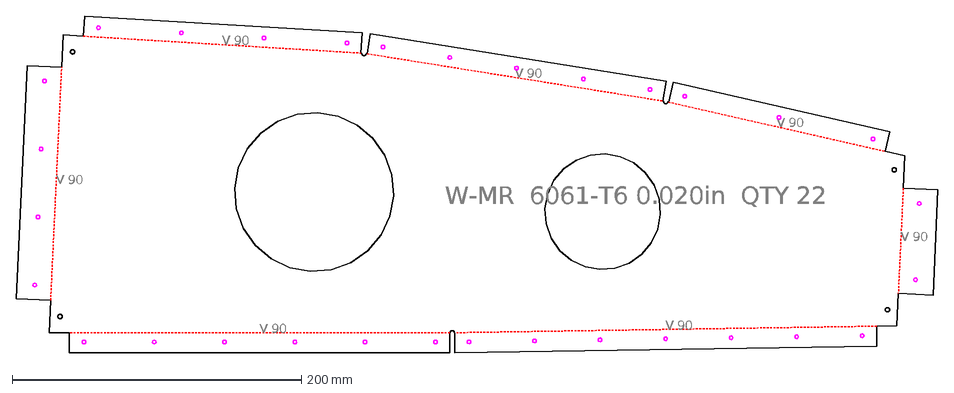
[picture p33: CAD file, 2026-10-21]
files/dxf/parts/W-MR.dxf
V 90
W-MR 6061-T6 0.020in QTY 22
