adampaigge/openplane/files/dxf/parts/W-SU3.dxf

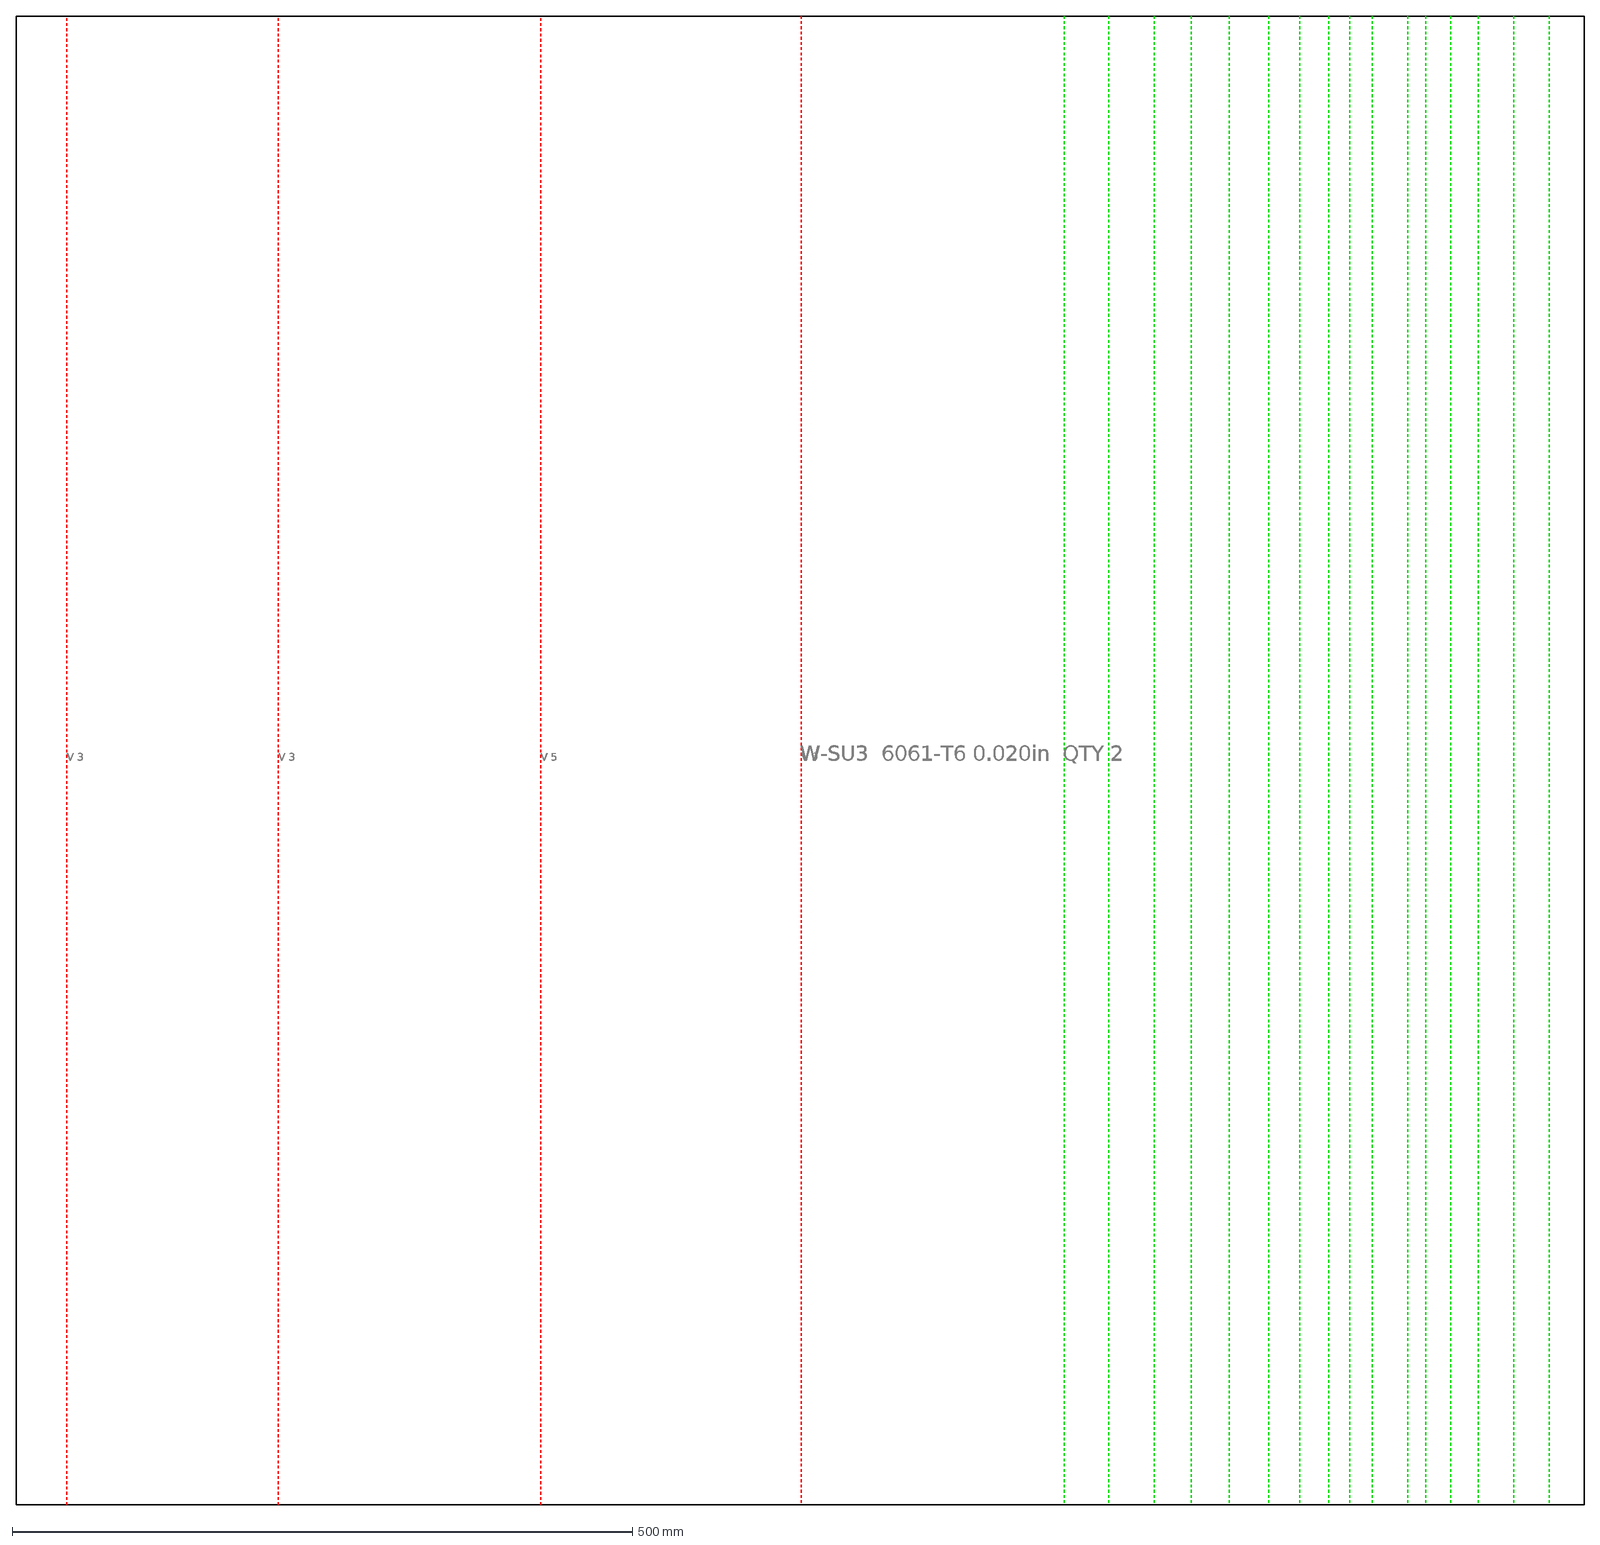
[picture p34: CAD file, 2026-10-21]
files/dxf/parts/W-SU3.dxf
V 9
V 5
V 3
W-SU3 6061-T6 0.020in QTY 2
