adampaigge/openplane/files/dxf/parts/S-GF.dxf

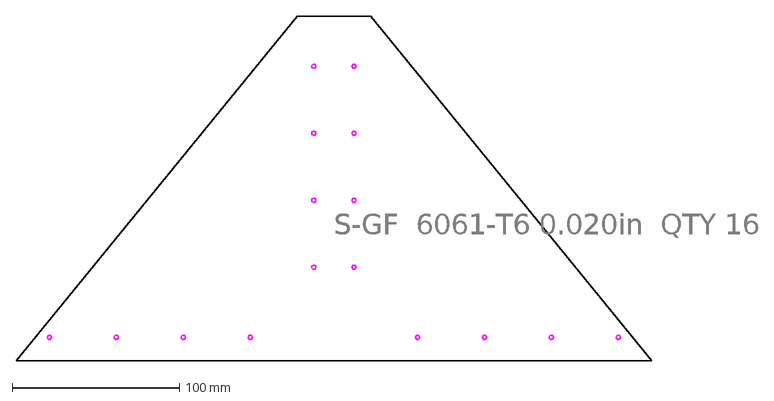
[picture p35: CAD file, 2026-10-21]
files/dxf/parts/S-GF.dxf
S-GF 6061-T6 0.020in QTY 16
