adampaigge/openplane/files/dxf/parts/F-B5.dxf

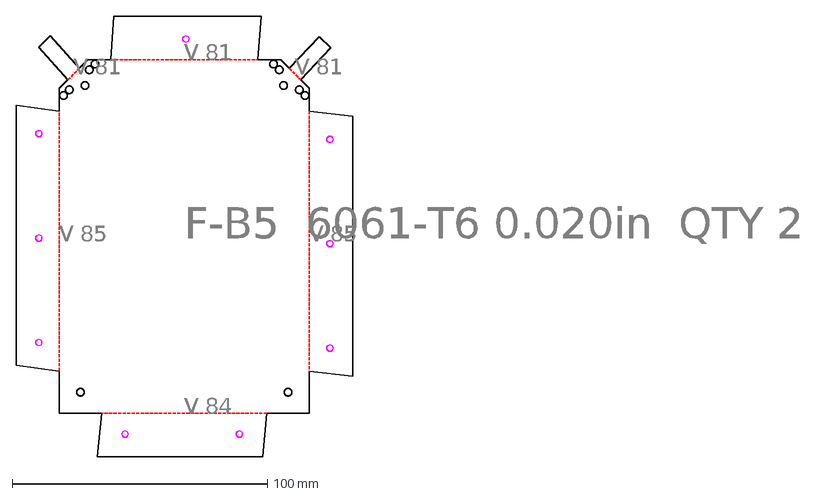
[picture p36: CAD file, 2026-10-21]
files/dxf/parts/F-B5.dxf
V 84
V 85
V 81
F-B5 6061-T6 0.020in QTY 2
