adampaigge/openplane/files/dxf/parts/W-CU.dxf

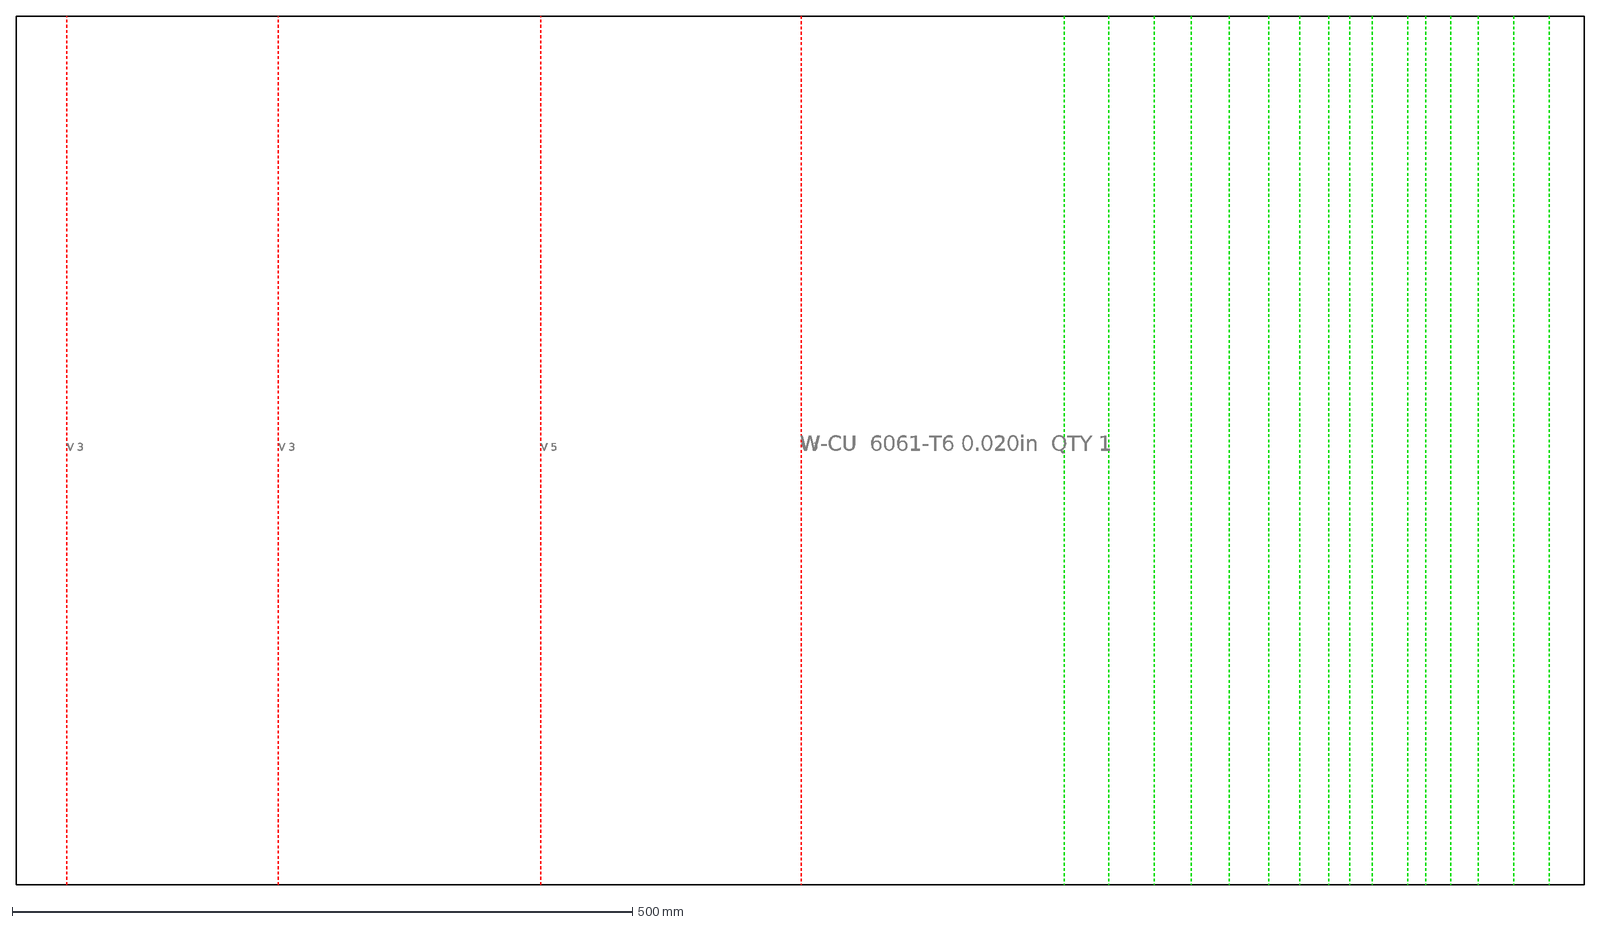
[picture p37: CAD file, 2026-10-21]
files/dxf/parts/W-CU.dxf
V 9
V 5
V 3
W-CU 6061-T6 0.020in QTY 1
