adampaigge/openplane/files/dxf/nests/Polycarbonate_2_mm_01.dxf

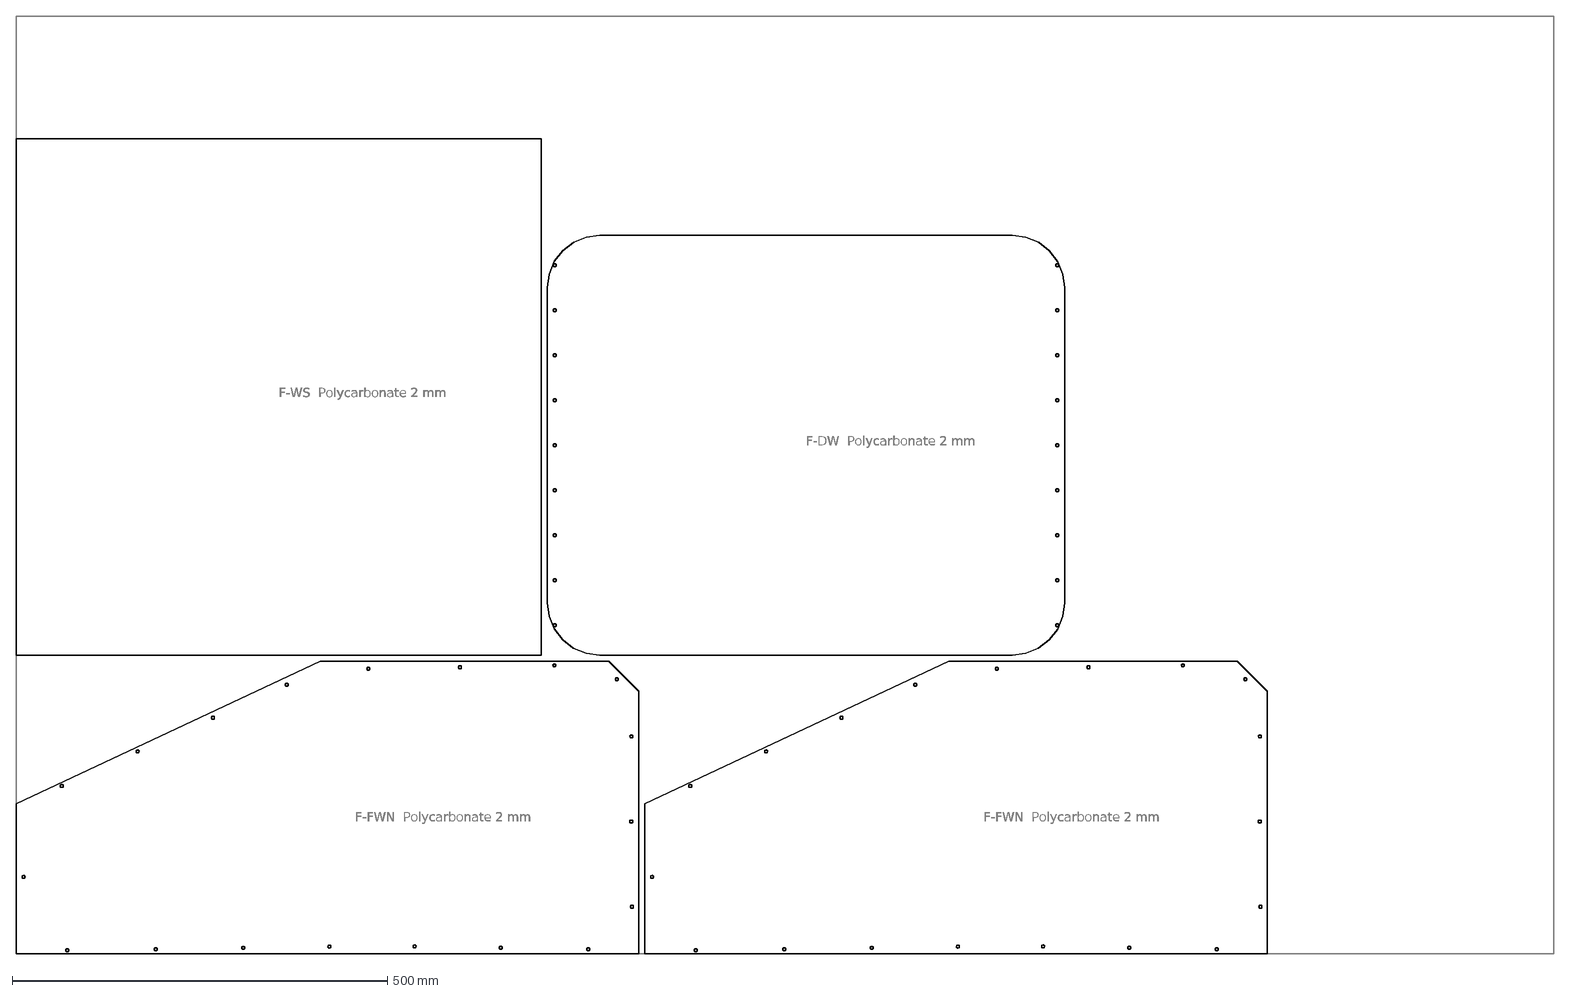
[picture p38: CAD file, 2026-10-21]
files/dxf/nests/Polycarbonate_2_mm_01.dxf
F-FWN Polycarbonate 2 mm
F-WS Polycarbonate 2 mm
F-DW Polycarbonate 2 mm
