adampaigge/openplane/files/dxf/parts/F-DW.dxf

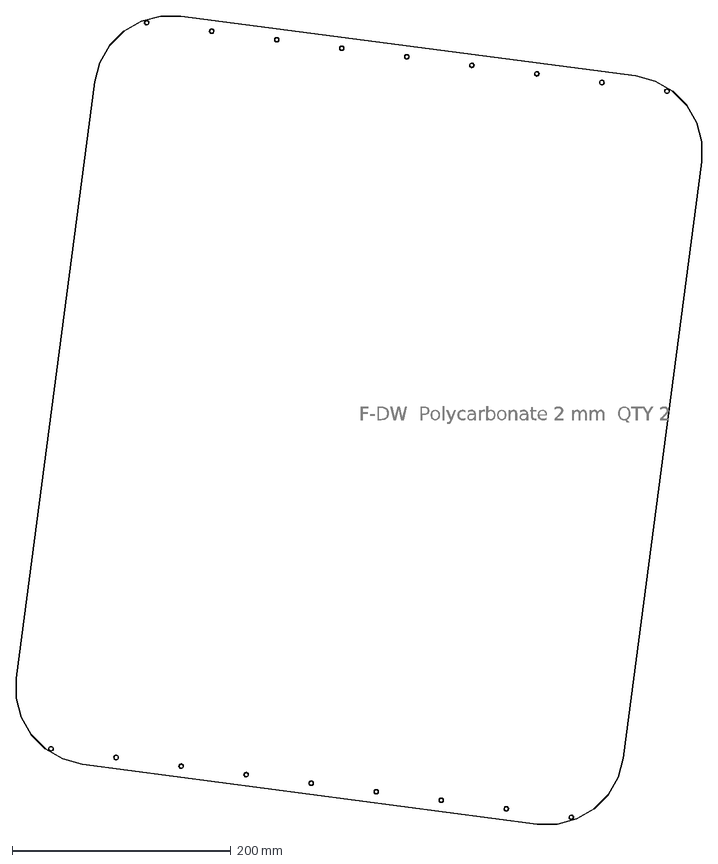
[picture p39: CAD file, 2026-10-21]
files/dxf/parts/F-DW.dxf
F-DW Polycarbonate 2 mm QTY 2
