adampaigge/openplane/files/dxf/parts/T-HS.dxf

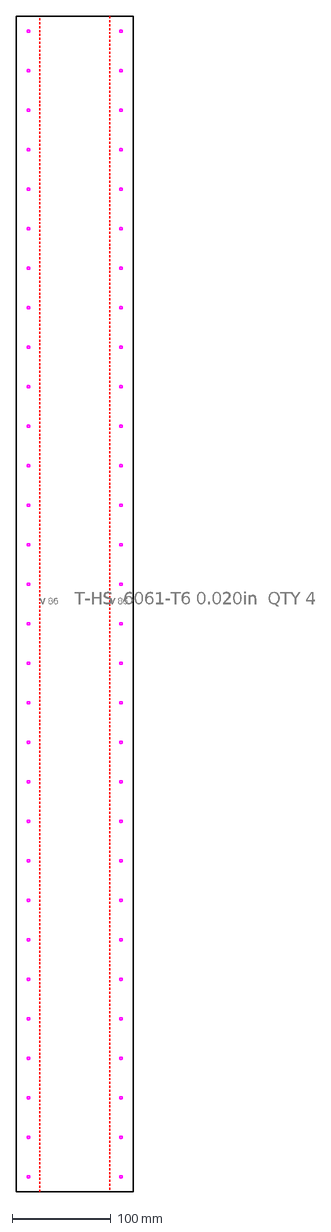
[picture p40: CAD file, 2026-10-21]
files/dxf/parts/T-HS.dxf
V 86
T-HS 6061-T6 0.020in QTY 4
