adampaigge/openplane/files/dxf/parts/K-JC.dxf

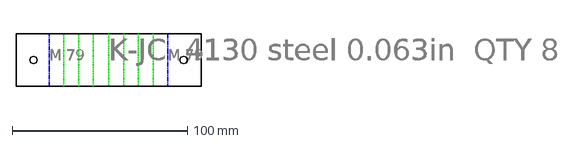
[picture p41: CAD file, 2026-10-21]
files/dxf/parts/K-JC.dxf
M 79
K-JC 4130 steel 0.063in QTY 8
