adampaigge/openplane/files/dxf/parts/F-FW.dxf

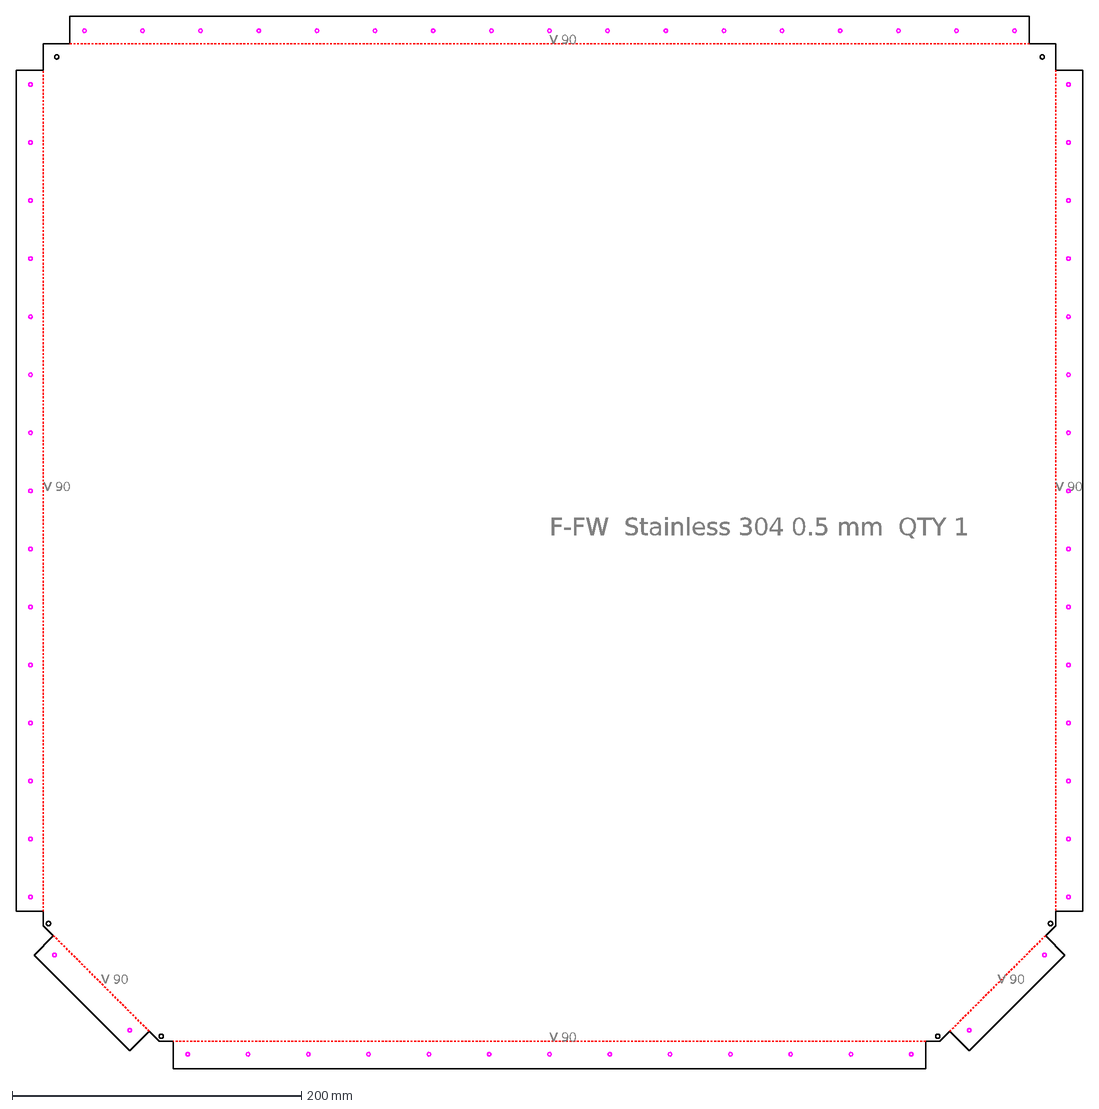
[picture p43: CAD file, 2026-10-21]
files/dxf/parts/F-FW.dxf
V 90
F-FW Stainless 304 0.5 mm QTY 1
