adampaigge/openplane/files/dxf/parts/K-TG.dxf

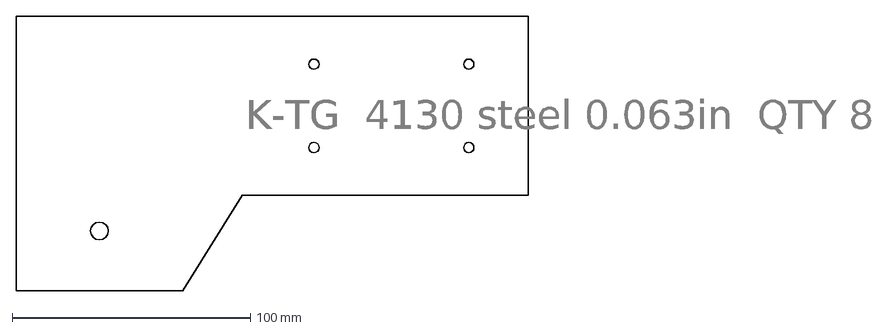
[picture p44: CAD file, 2026-10-21]
files/dxf/parts/K-TG.dxf
K-TG 4130 steel 0.063in QTY 8
