adampaigge/openplane/files/dxf/parts/K-HD.dxf

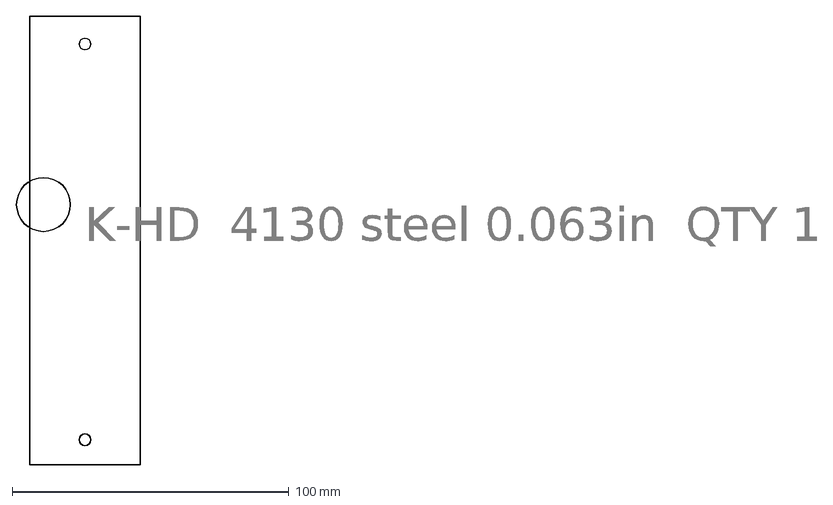
[picture p45: CAD file, 2026-10-21]
files/dxf/parts/K-HD.dxf
K-HD 4130 steel 0.063in QTY 1
