adampaigge/openplane/files/dxf/parts/S-BM.dxf

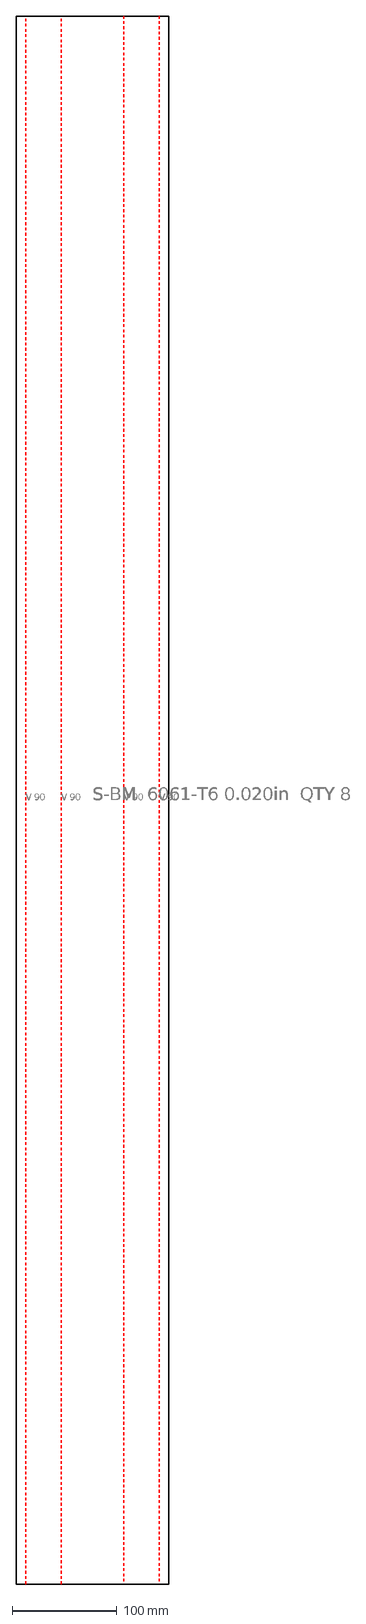
[picture p46: CAD file, 2026-10-21]
files/dxf/parts/S-BM.dxf
V 90
S-BM 6061-T6 0.020in QTY 8
