adampaigge/openplane/files/dxf/parts/W-NR.dxf

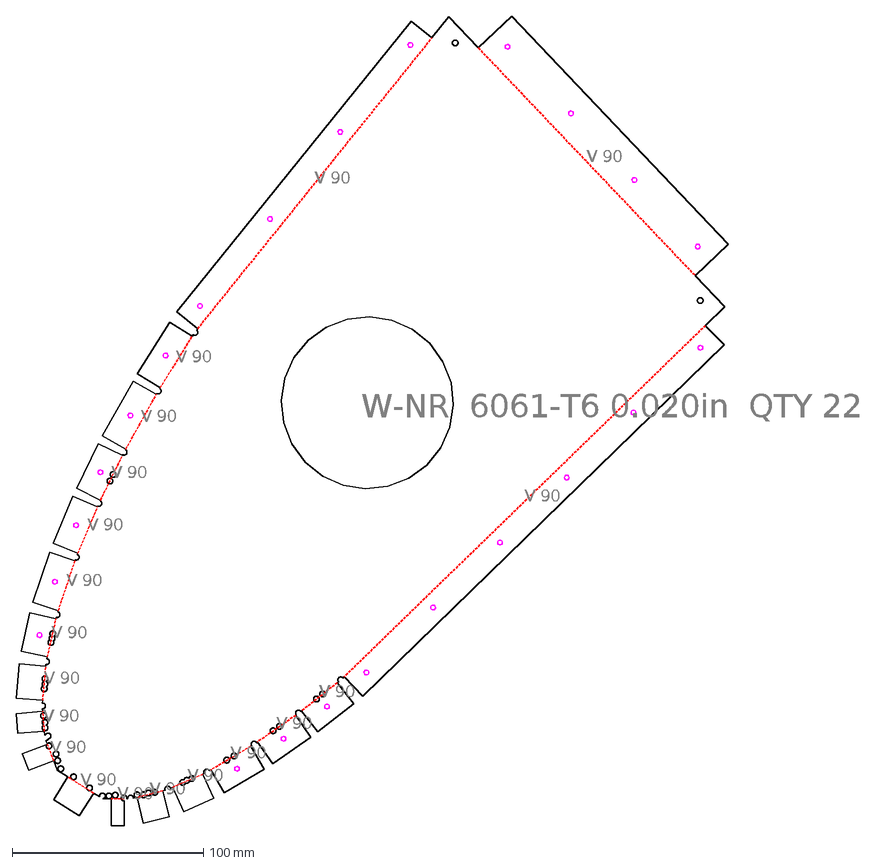
[picture p47: CAD file, 2026-10-21]
files/dxf/parts/W-NR.dxf
V 90
W-NR 6061-T6 0.020in QTY 22
