adampaigge/openplane/files/dxf/parts/F-FA.dxf

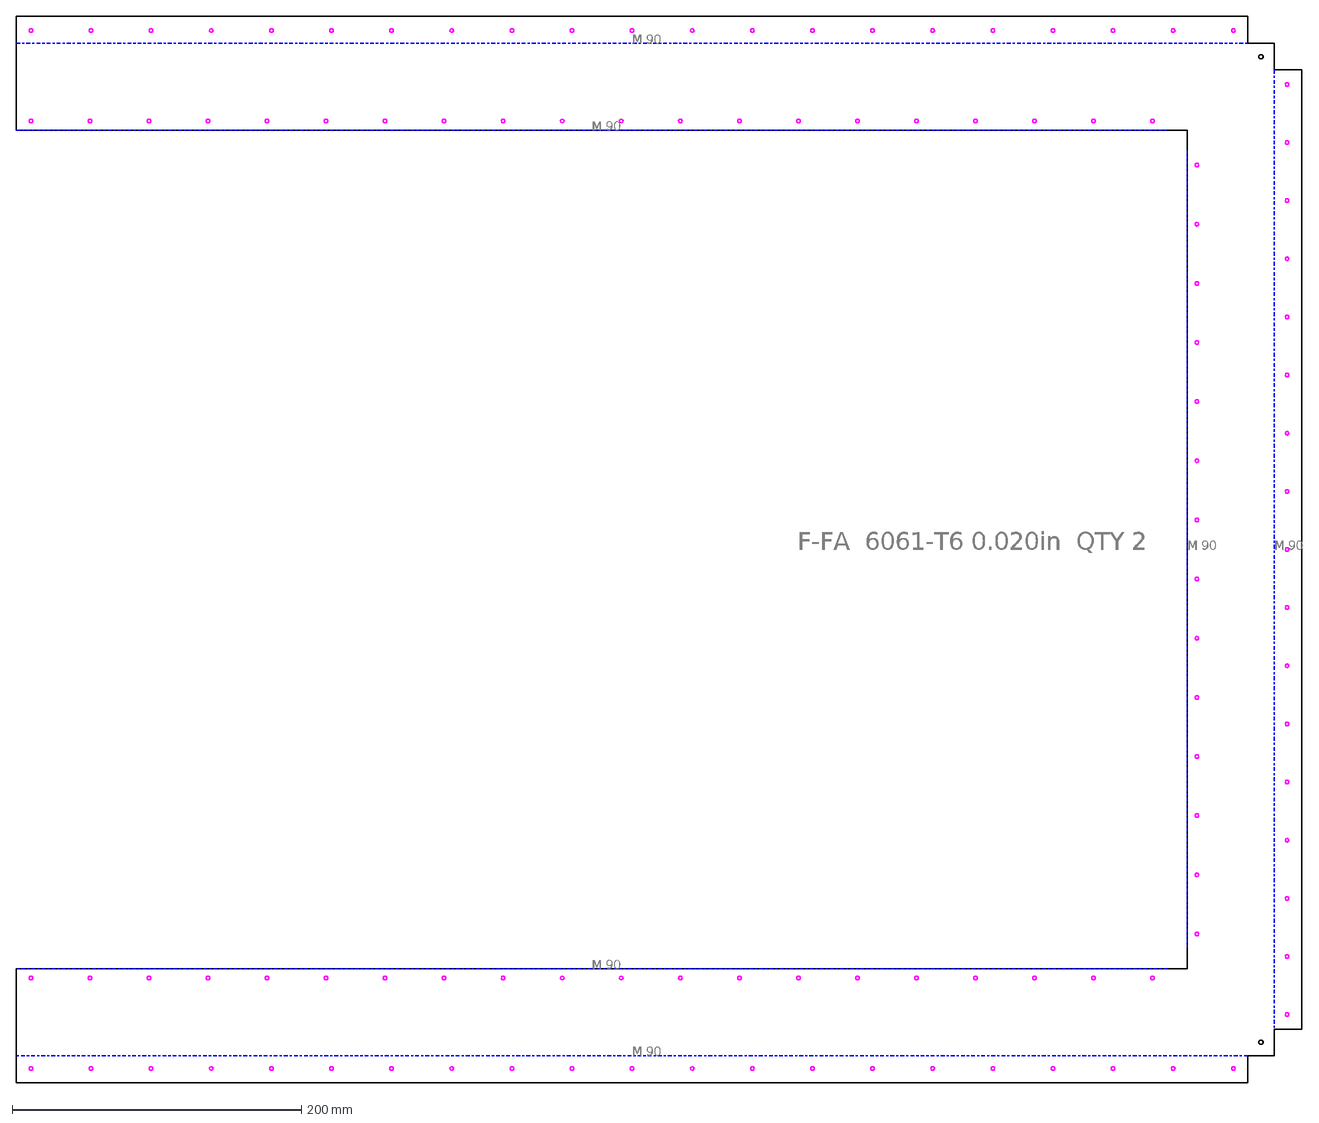
[picture p48: CAD file, 2026-10-21]
files/dxf/parts/F-FA.dxf
M 90
F-FA 6061-T6 0.020in QTY 2
