adampaigge/openplane/files/dxf/parts/K-BC.dxf

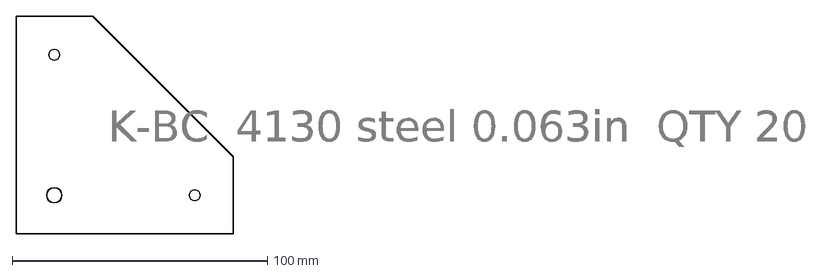
[picture p49: CAD file, 2026-10-21]
files/dxf/parts/K-BC.dxf
K-BC 4130 steel 0.063in QTY 20
