adampaigge/openplane/files/dxf/parts/F-TS2.dxf

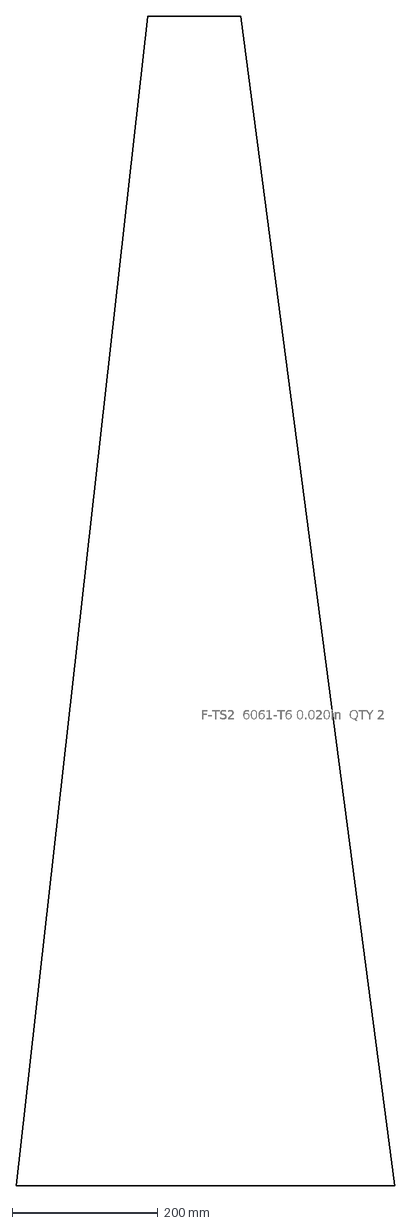
[picture p50: CAD file, 2026-10-21]
files/dxf/parts/F-TS2.dxf
F-TS2 6061-T6 0.020in QTY 2
