adampaigge/openplane/files/dxf/parts/F-RA.dxf

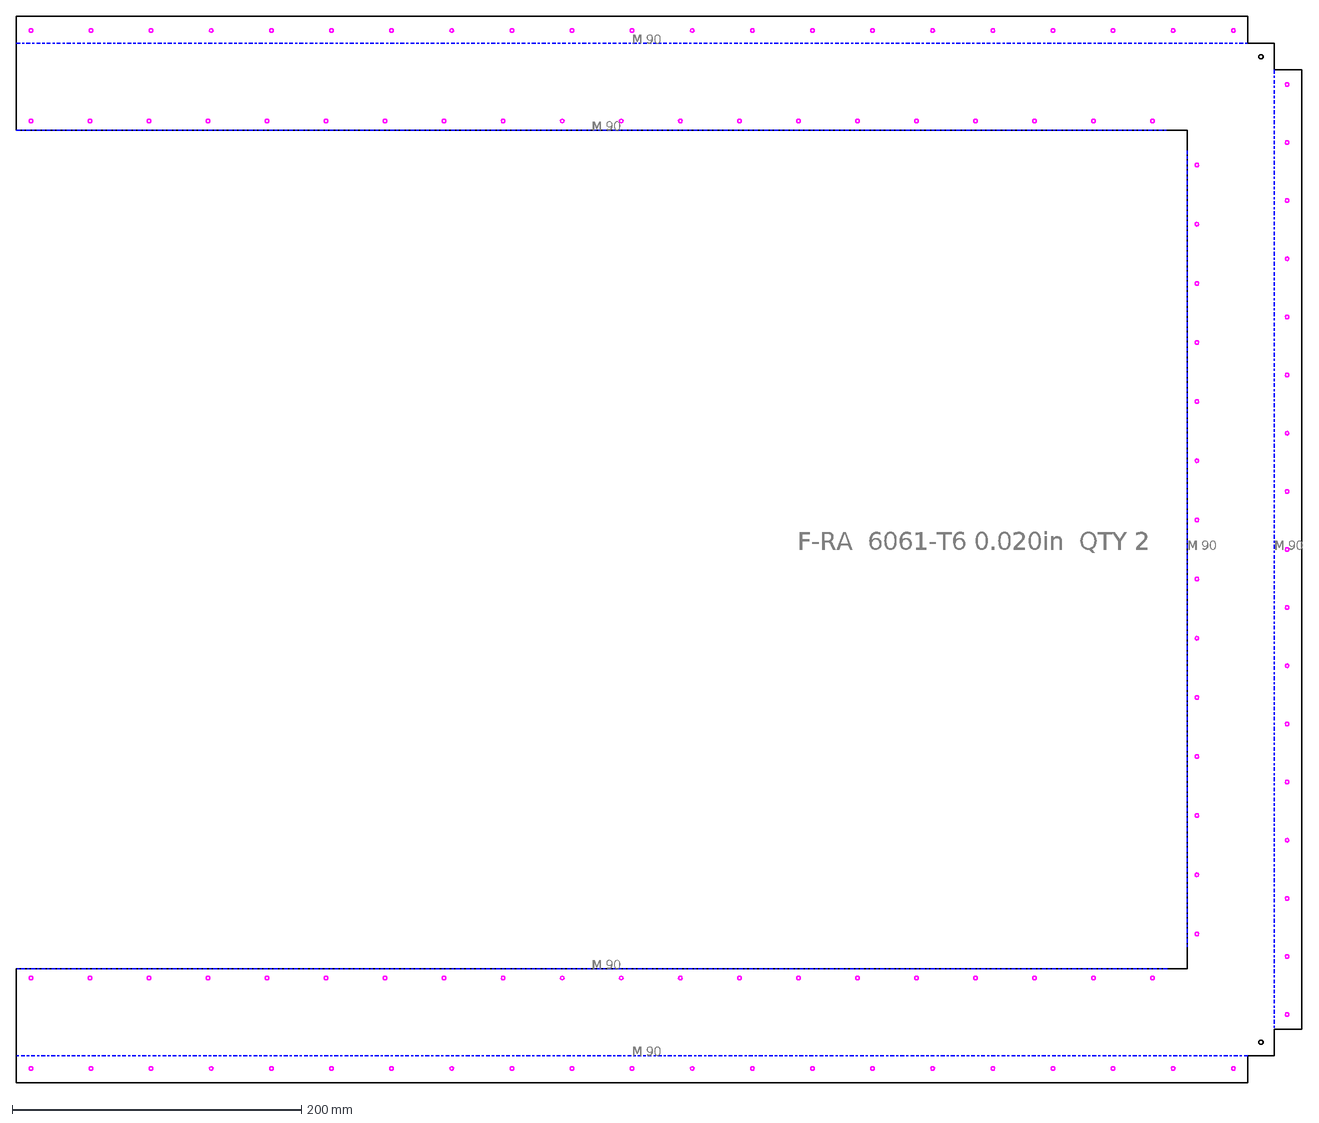
[picture p52: CAD file, 2026-10-21]
files/dxf/parts/F-RA.dxf
M 90
F-RA 6061-T6 0.020in QTY 2
