adampaigge/openplane/files/dxf/parts/W-NRe.dxf

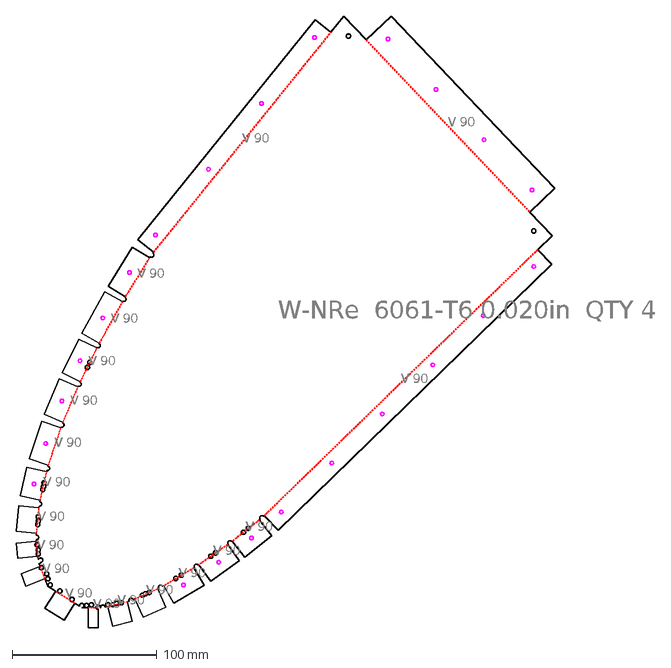
[picture p53: CAD file, 2026-10-21]
files/dxf/parts/W-NRe.dxf
V 90
W-NRe 6061-T6 0.020in QTY 4
