adampaigge/openplane/files/dxf/parts/F-NL.dxf

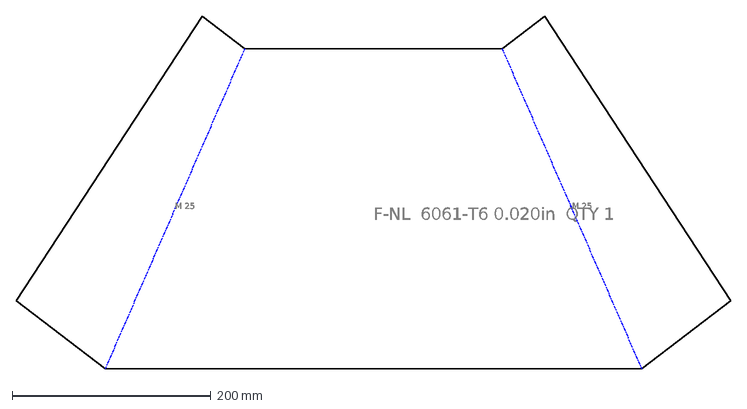
[picture p54: CAD file, 2026-10-21]
files/dxf/parts/F-NL.dxf
M 25
F-NL 6061-T6 0.020in QTY 1
