adampaigge/openplane/files/dxf/parts/W-CL.dxf

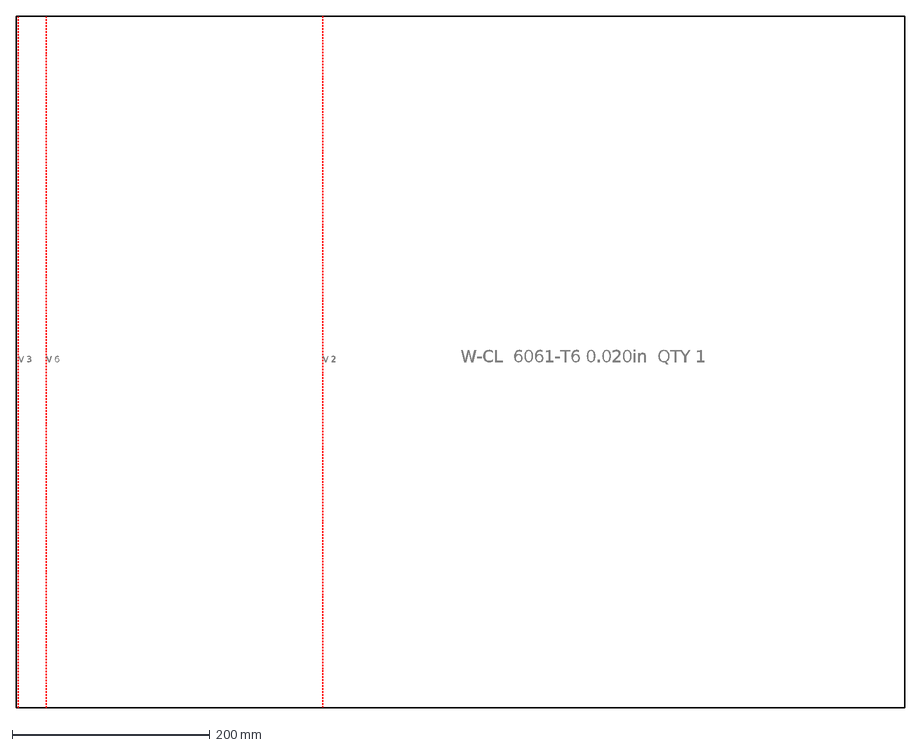
[picture p55: CAD file, 2026-10-21]
files/dxf/parts/W-CL.dxf
V 2
V 6
V 3
W-CL 6061-T6 0.020in QTY 1
