adampaigge/openplane/files/dxf/parts/S-GT.dxf

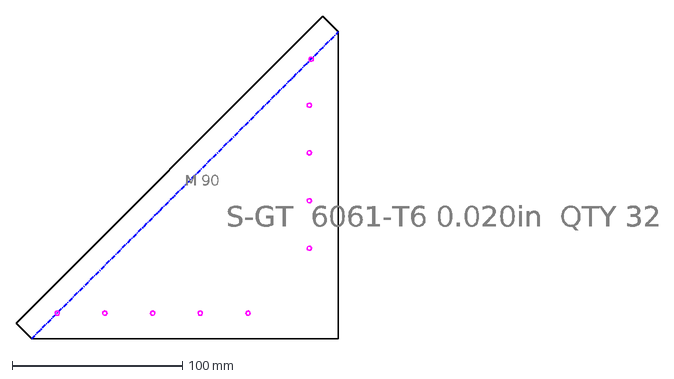
[picture p56: CAD file, 2026-10-21]
files/dxf/parts/S-GT.dxf
M 90
S-GT 6061-T6 0.020in QTY 32
