adampaigge/openplane/files/dxf/parts/F-WS.dxf

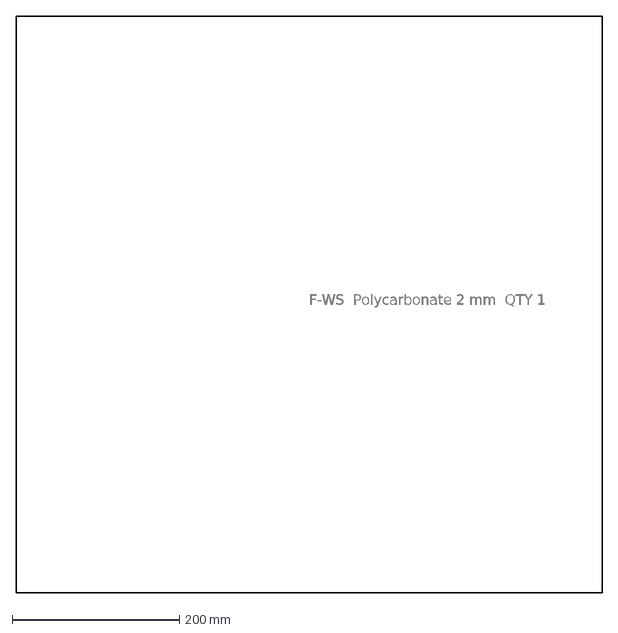
[picture p57: CAD file, 2026-10-21]
files/dxf/parts/F-WS.dxf
F-WS Polycarbonate 2 mm QTY 1
