adampaigge/openplane/files/dxf/parts/W-CT.dxf

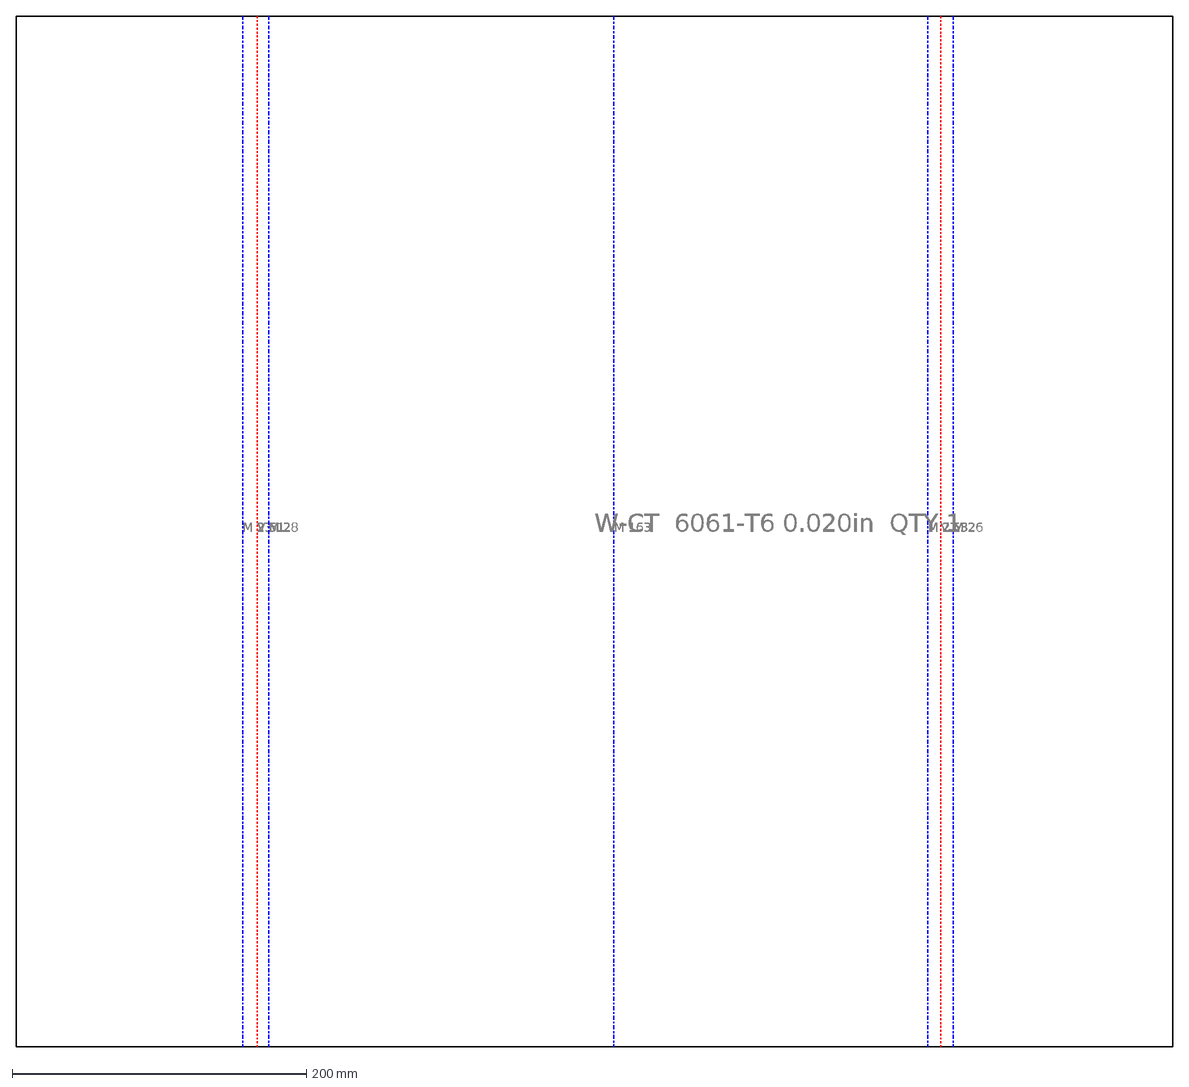
[picture p58: CAD file, 2026-10-21]
files/dxf/parts/W-CT.dxf
M 23
V 51
M 28
M 163
M 27
V 53
M 26
W-CT 6061-T6 0.020in QTY 1
