adampaigge/openplane/files/dxf/parts/W-SL3.dxf

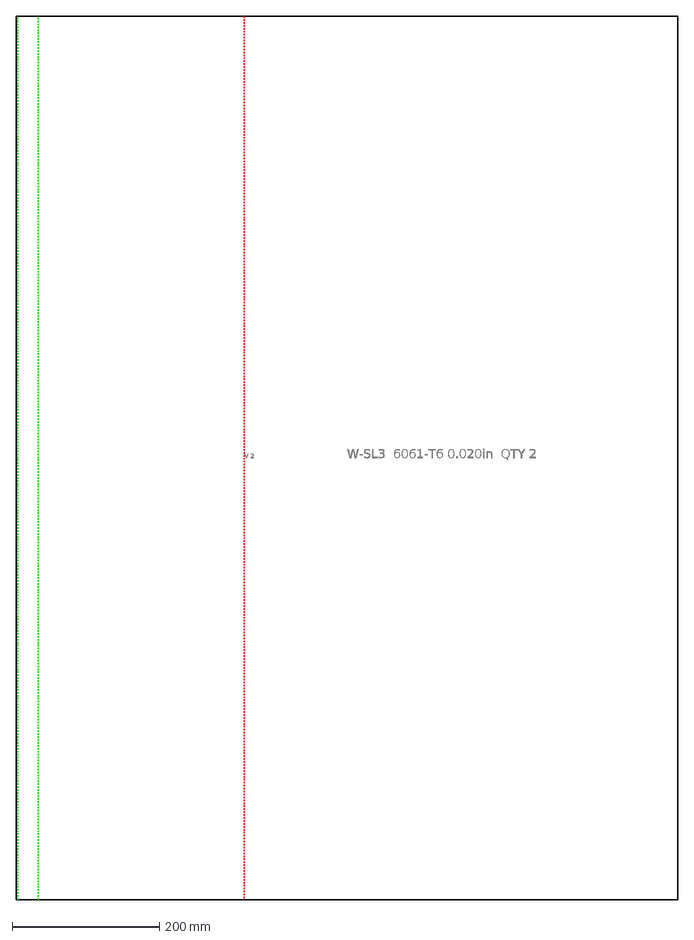
[picture p59: CAD file, 2026-10-21]
files/dxf/parts/W-SL3.dxf
V 2
W-SL3 6061-T6 0.020in QTY 2
