adampaigge/openplane/files/dxf/parts/K-CV.dxf

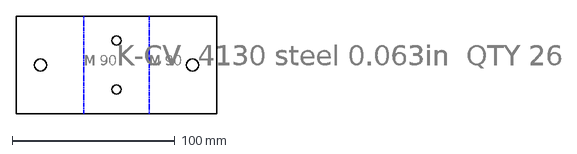
[picture p60: CAD file, 2026-10-21]
files/dxf/parts/K-CV.dxf
M 90
K-CV 4130 steel 0.063in QTY 26
