adampaigge/openplane/files/dxf/parts/F-TT2.dxf

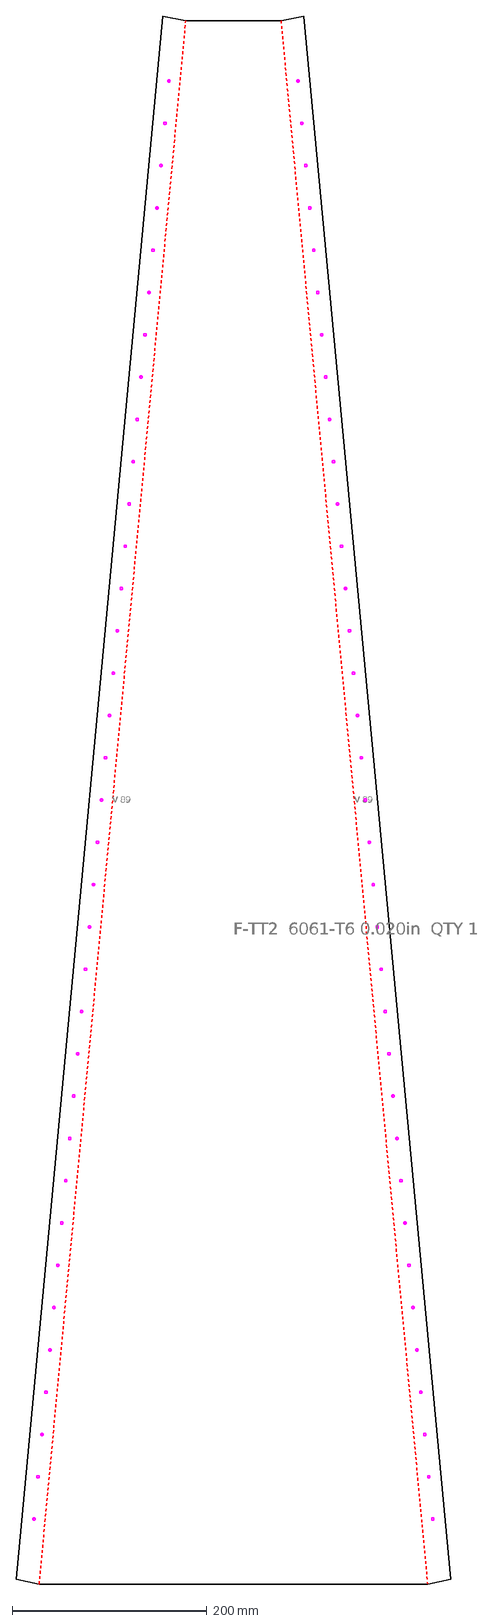
[picture p61: CAD file, 2026-10-21]
files/dxf/parts/F-TT2.dxf
V 89
F-TT2 6061-T6 0.020in QTY 1
