adampaigge/openplane/files/dxf/parts/T-ES.dxf

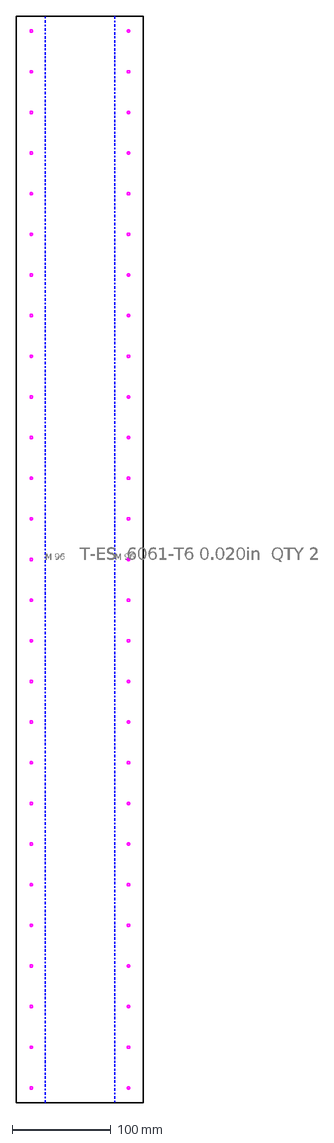
[picture p62: CAD file, 2026-10-21]
files/dxf/parts/T-ES.dxf
M 96
T-ES 6061-T6 0.020in QTY 2
