adampaigge/openplane/files/dxf/parts/F-ST.dxf

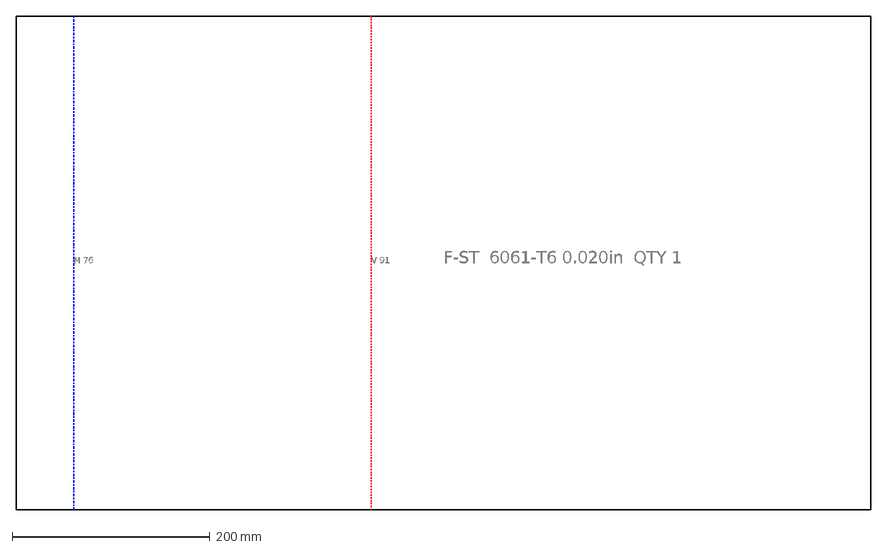
[picture p63: CAD file, 2026-10-21]
files/dxf/parts/F-ST.dxf
V 91
M 76
F-ST 6061-T6 0.020in QTY 1
