adampaigge/openplane/files/dxf/parts/F-FWN.dxf

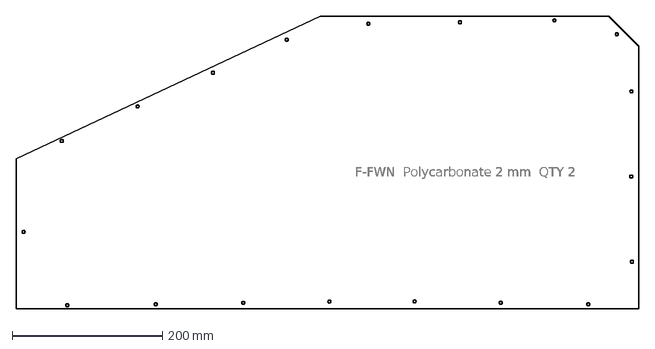
[picture p64: CAD file, 2026-10-21]
files/dxf/parts/F-FWN.dxf
F-FWN Polycarbonate 2 mm QTY 2
