adampaigge/openplane/files/dxf/parts/T-RK.dxf

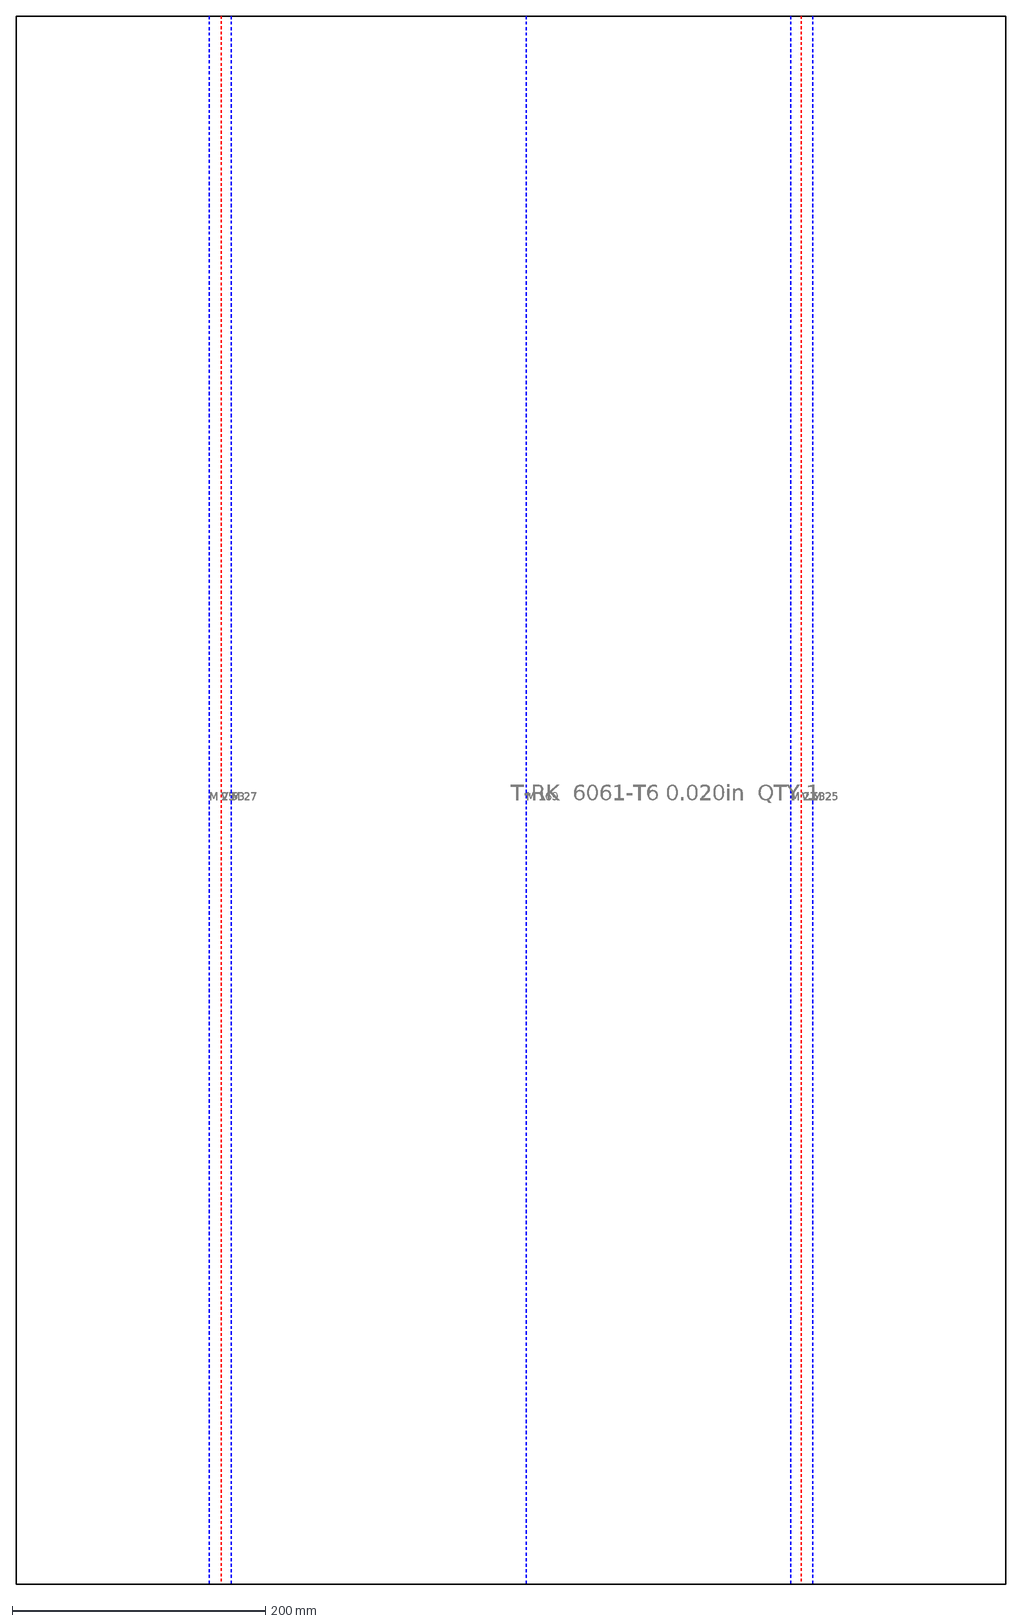
[picture p65: CAD file, 2026-10-21]
files/dxf/parts/T-RK.dxf
M 25
V 53
M 27
M 169
T-RK 6061-T6 0.020in QTY 1
