adampaigge/openplane/(list of files, cad)

Other CAD files:
files/dxf/nests/6061-T6_0020in_24.dxf
files/dxf/nests/6061-T6_0020in_11.dxf
files/dxf/nests/6061-T6_0020in_12.dxf
files/dxf/nests/6061-T6_0020in_13.dxf
files/dxf/nests/6061-T6_0020in_21.dxf
files/dxf/nests/6061-T6_0020in_14.dxf
files/dxf/nests/6061-T6_0020in_09.dxf
files/dxf/nests/6061-T6_0020in_23.dxf
files/dxf/nests/6061-T6_0020in_28.dxf
files/dxf/nests/6061-T6_0020in_26.dxf
files/dxf/nests/6061-T6_0020in_02.dxf
files/dxf/nests/6061-T6_0020in_25.dxf
files/dxf/nests/6061-T6_0020in_05.dxf
files/dxf/nests/6061-T6_0020in_27.dxf
files/dxf/nests/6061-T6_0020in_10.dxf
files/dxf/nests/6061-T6_0020in_17.dxf
files/dxf/nests/6061-T6_0020in_04.dxf
files/dxf/nests/6061-T6_0020in_01.dxf
files/dxf/parts/W-RS.dxf
files/dxf/nests/6061-T6_0020in_06.dxf
files/dxf/nests/6061-T6_0020in_20.dxf
files/dxf/nests/6061-T6_0020in_07.dxf
files/dxf/nests/6061-T6_0020in_03.dxf
files/dxf/nests/6061-T6_0020in_08.dxf
files/dxf/nests/6061-T6_0020in_30.dxf
files/dxf/nests/6061-T6_0020in_29.dxf
files/dxf/nests/6061-T6_0020in_16.dxf
files/dxf/parts/W-CS.dxf
files/dxf/nests/6061-T6_0020in_22.dxf
files/dxf/nests/Stainless_304_05_mm_01.dxf
files/dxf/parts/W-CSS.dxf
files/dxf/parts/F-TB1.dxf
files/dxf/parts/F-FL.dxf
files/dxf/parts/W-MS.dxf
files/dxf/parts/F-TB2.dxf
files/prop/OpenPlane_prop_54x24.obj
